FrankBetances/lua-construye/docs/lua-v5-camino-lado.png

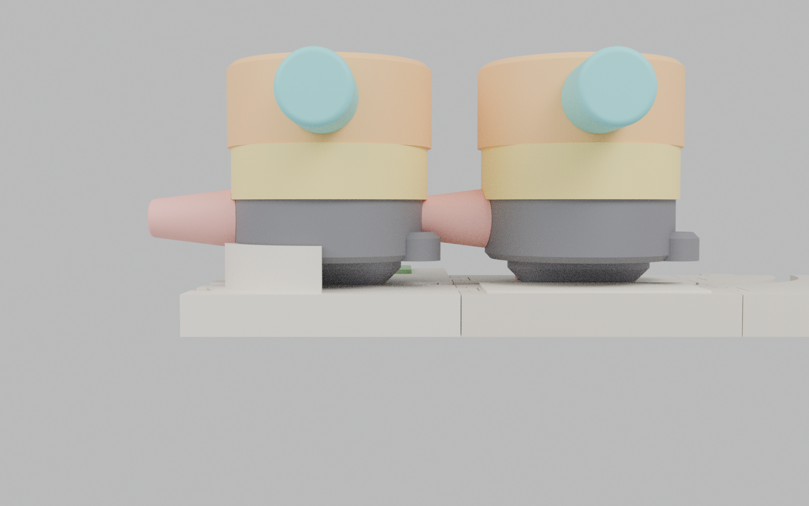
docs/lua-v5-camino-lado.png
