FrankBetances/lua-construye/docs/lua-v5-camino.png

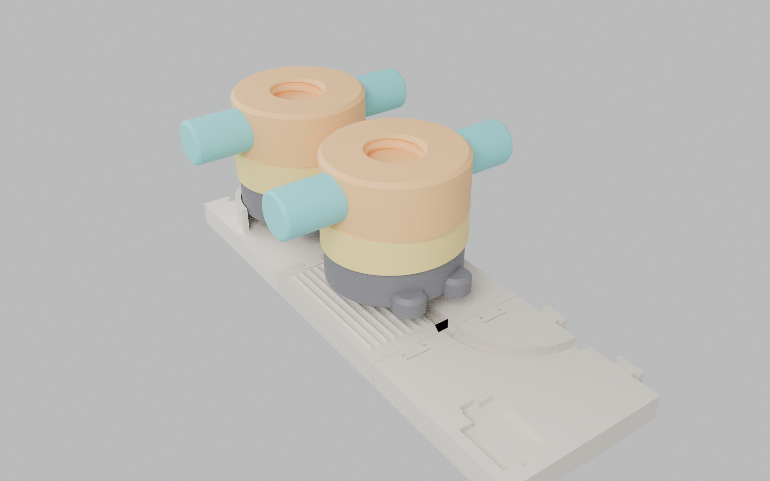
docs/lua-v5-camino.png
