FrankBetances/lua-construye/escenas-juego/escenas/S0-kit-lua.png

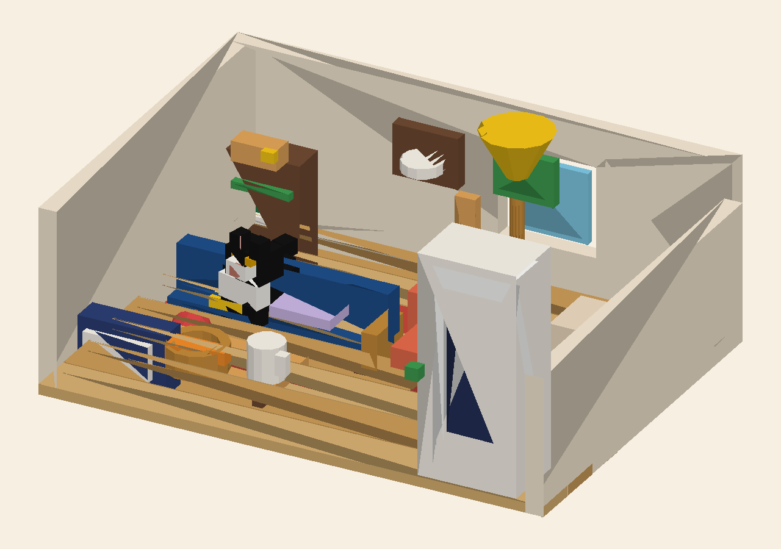
escenas-juego/escenas/S0-kit-lua.png
