FrankBetances/lua-construye/escenas-juego/escenas/S1-camino.png

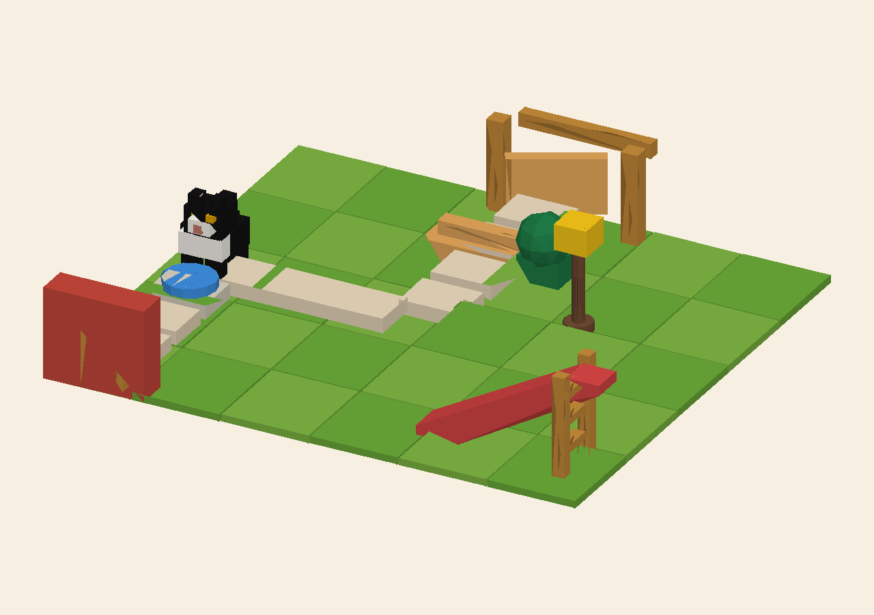
escenas-juego/escenas/S1-camino.png
