FrankBetances/lua-construye/escenas-juego/escenas/S2-estacion-sonido.png

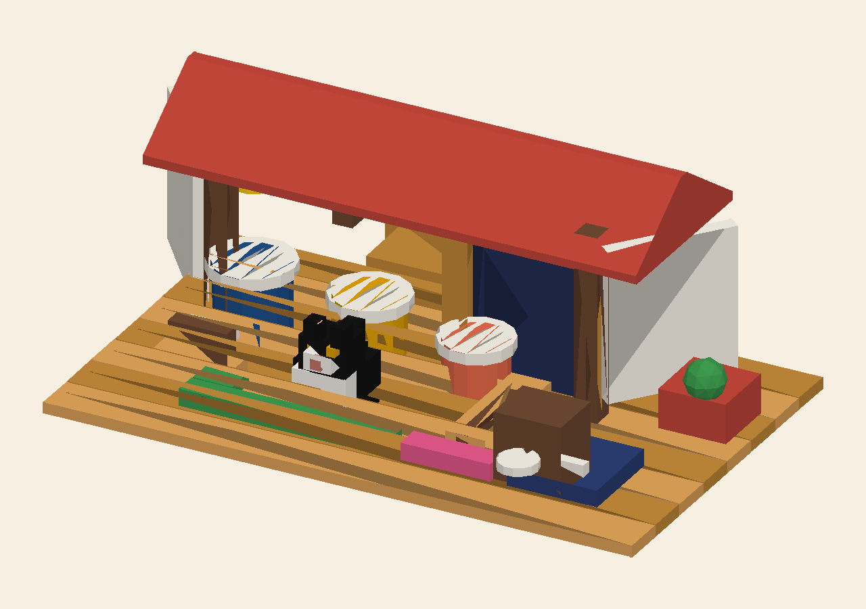
escenas-juego/escenas/S2-estacion-sonido.png
