FrankBetances/lua-construye/escenas-juego/escenas/S3-laboratorio-rampas.png

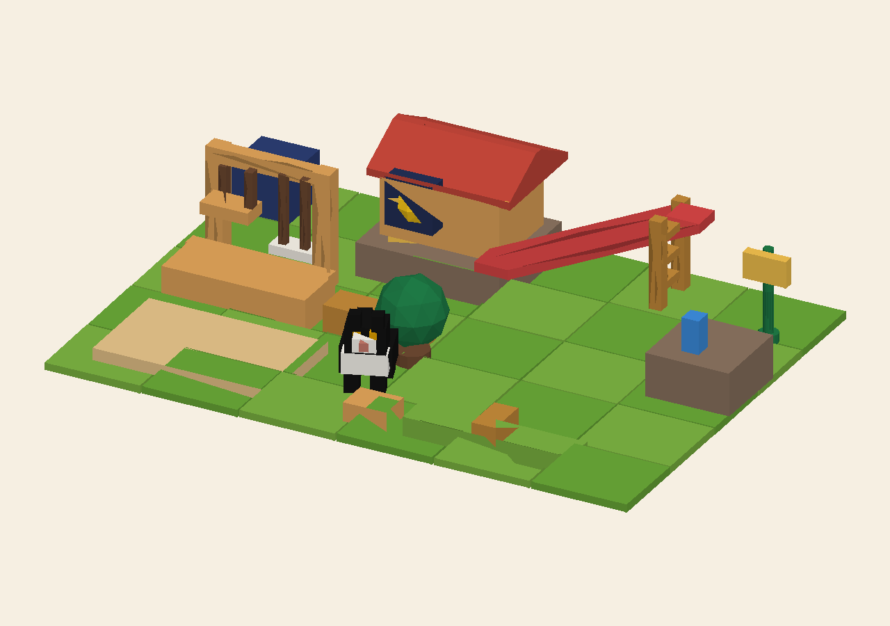
escenas-juego/escenas/S3-laboratorio-rampas.png
