FrankBetances/lua-construye/escenas-juego/escenas/S4-maquina-soplo.png

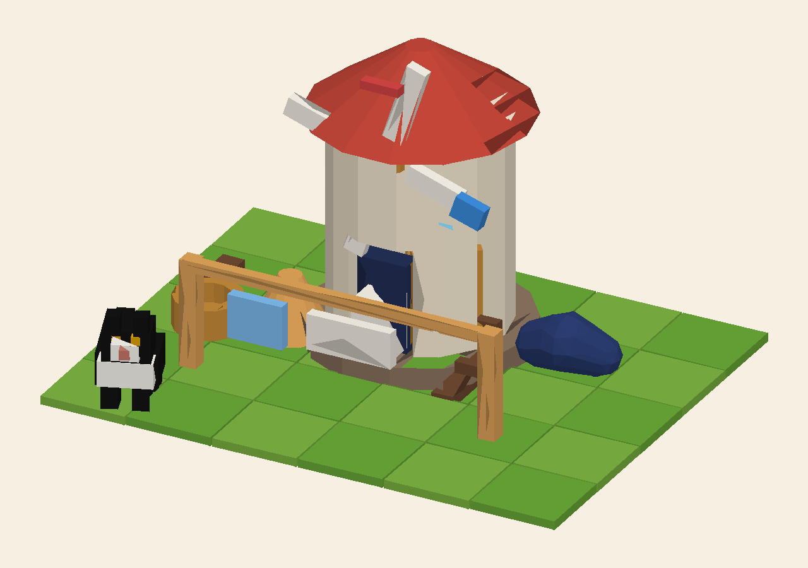
escenas-juego/escenas/S4-maquina-soplo.png
