FrankBetances/lua-construye/escenas-juego/escenas/S5-puente-equilibrio.png

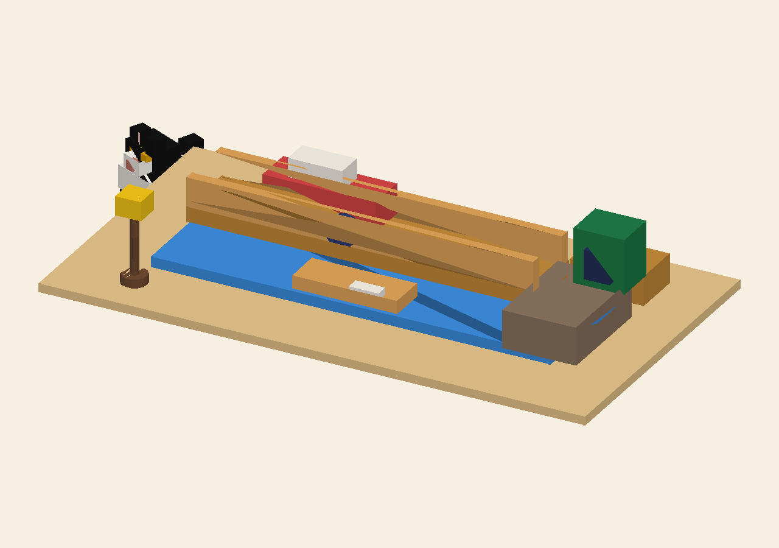
escenas-juego/escenas/S5-puente-equilibrio.png
