FrankBetances/lua-construye/escenas-juego/escenas/S6-jardin.png

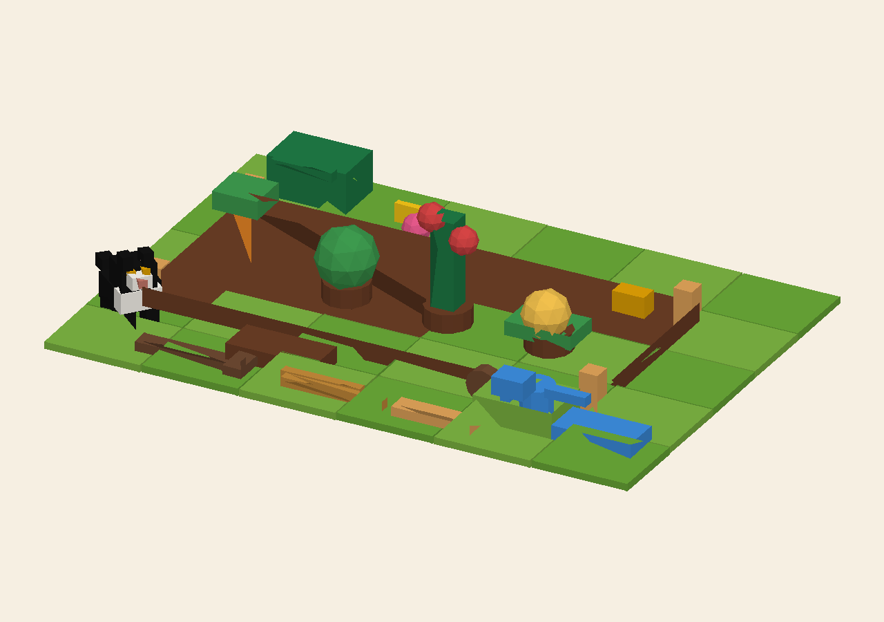
escenas-juego/escenas/S6-jardin.png
