FrankBetances/lua-construye/escenas-juego/escenas/S7-granja.png

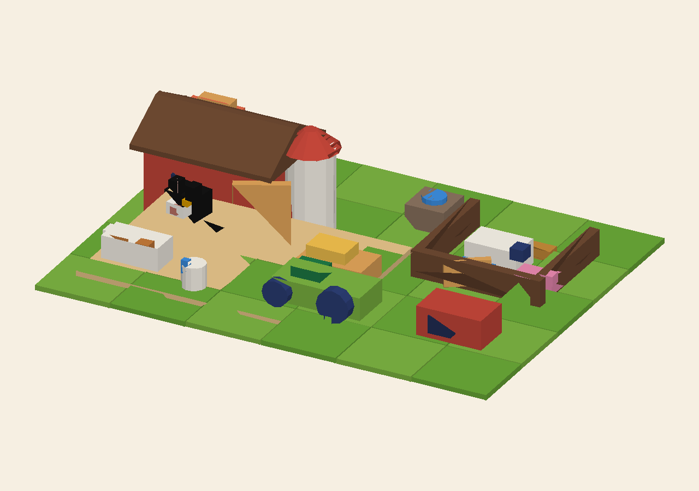
escenas-juego/escenas/S7-granja.png
