FrankBetances/lua-construye/sets/P1-probeta-encaje/tarjetas/despiece.png

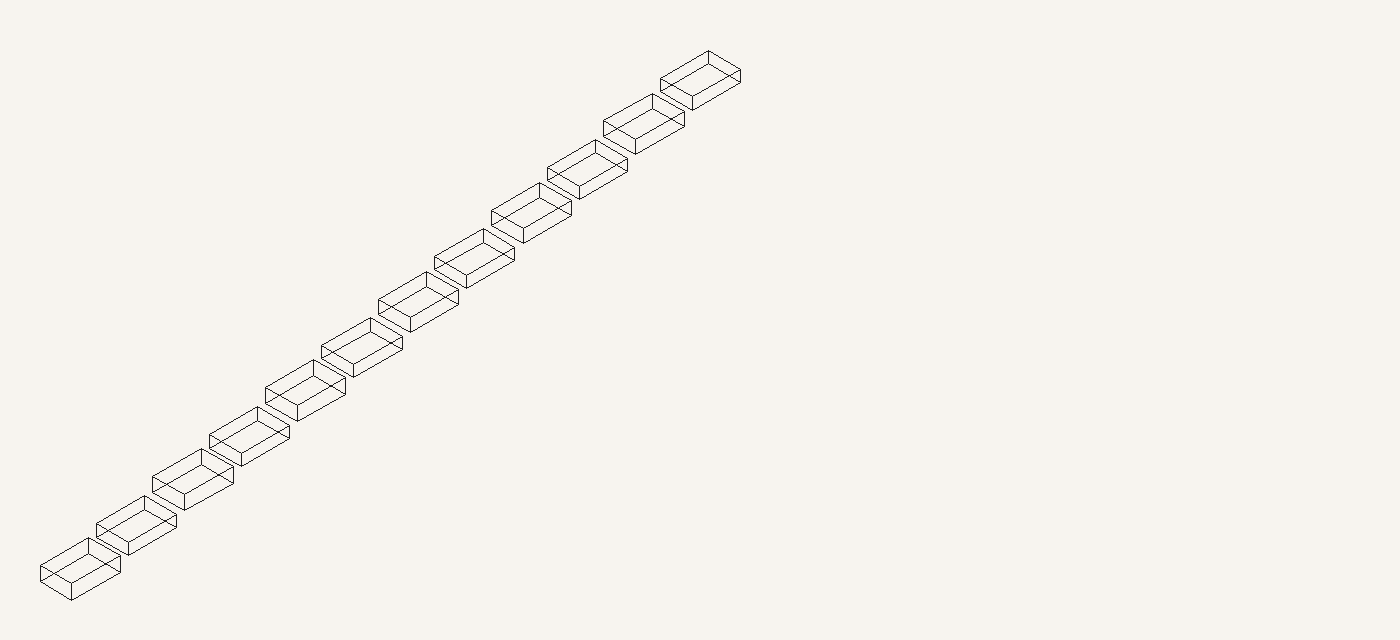
sets/P1-probeta-encaje/tarjetas/despiece.png
