FrankBetances/lua-construye/sets/P1-probeta-encaje/tarjetas/planta.png

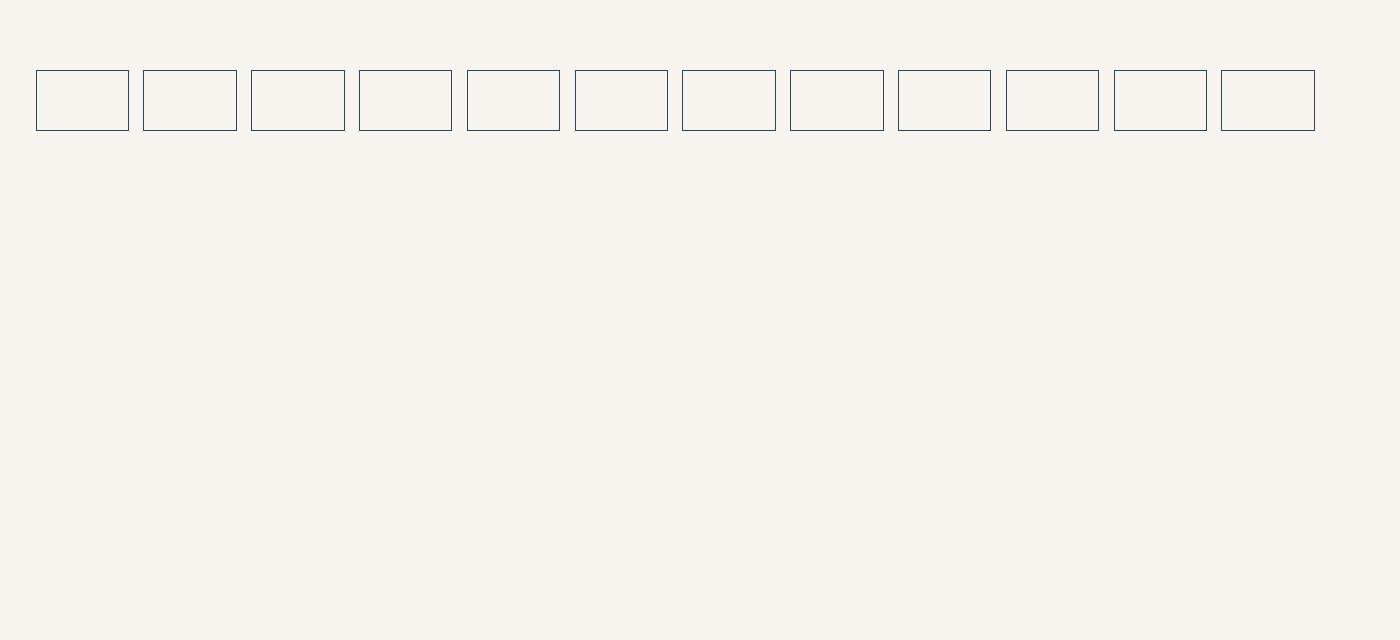
sets/P1-probeta-encaje/tarjetas/planta.png
