FrankBetances/lua-construye/sets/S0-kit-lua/tarjetas/despiece.png

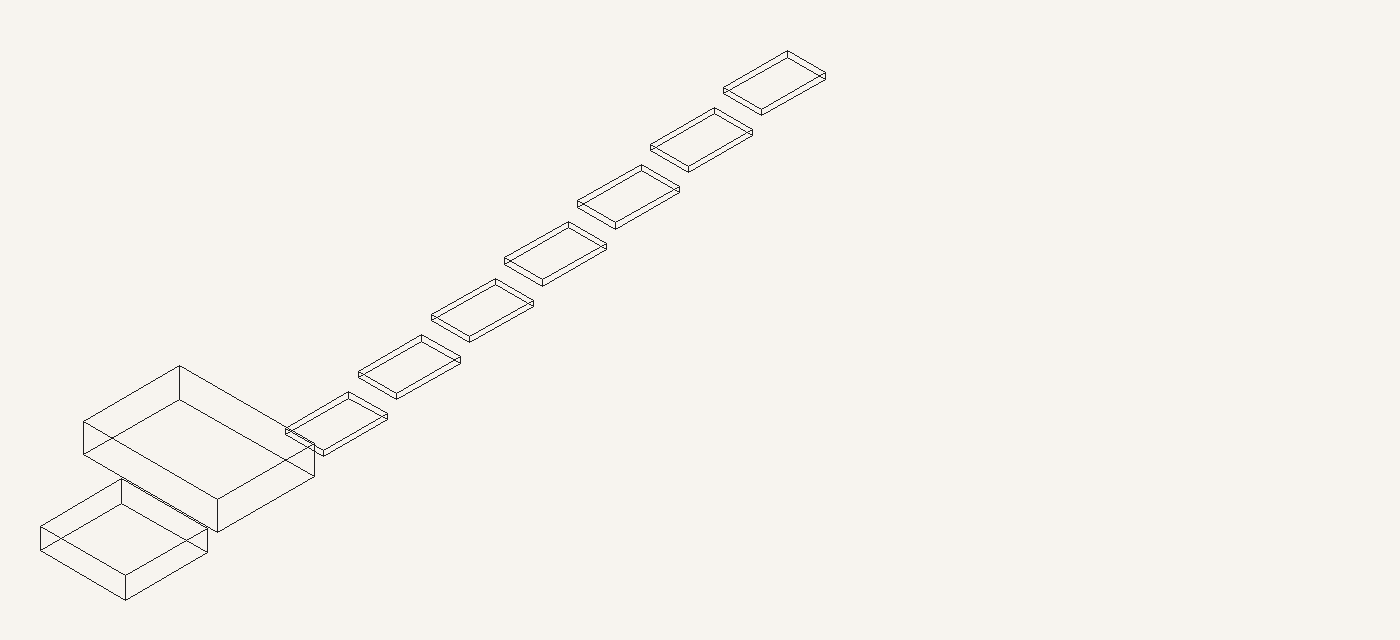
sets/S0-kit-lua/tarjetas/despiece.png
