FrankBetances/lua-construye/sets/S0-kit-lua/tarjetas/planta.png

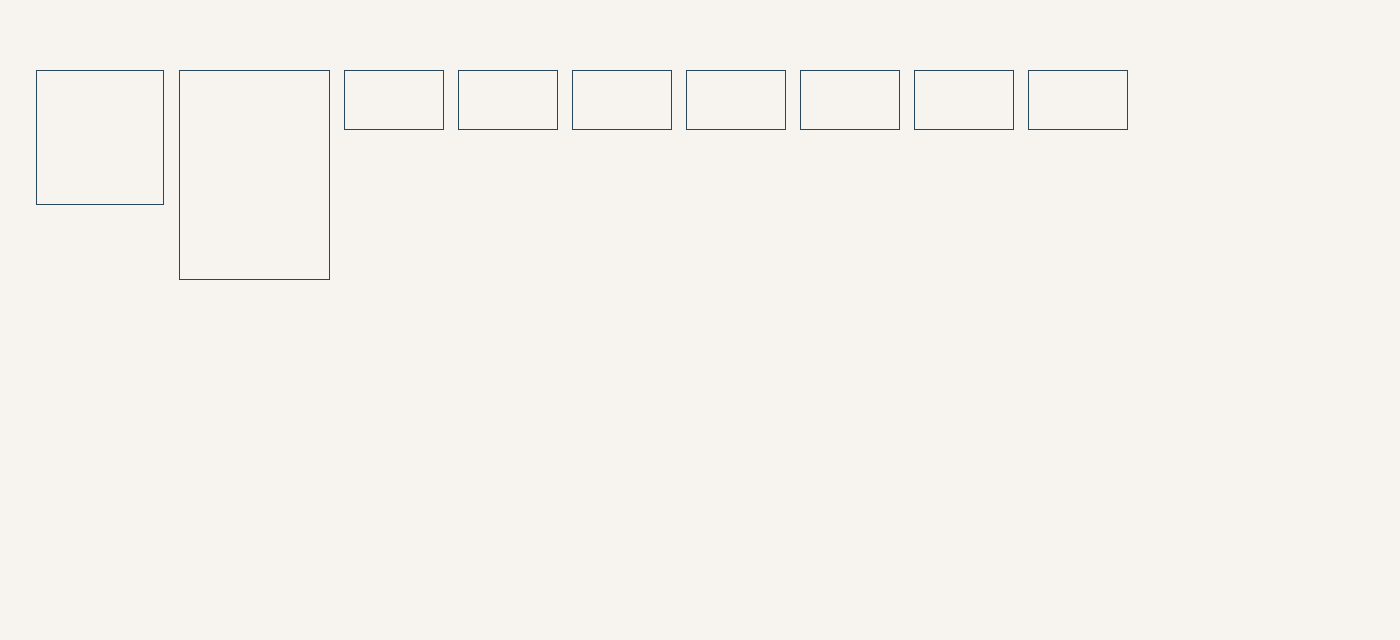
sets/S0-kit-lua/tarjetas/planta.png
