FrankBetances/lua-construye/sets/S1-camino/tarjetas/curva-planta.png

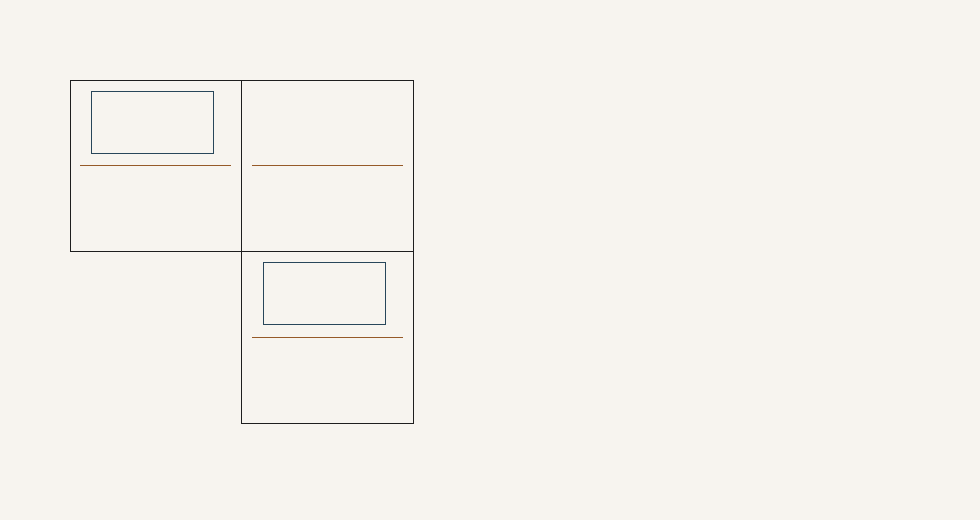
sets/S1-camino/tarjetas/curva-planta.png
