FrankBetances/lua-construye/sets/S1-camino/tarjetas/recta-despiece.png

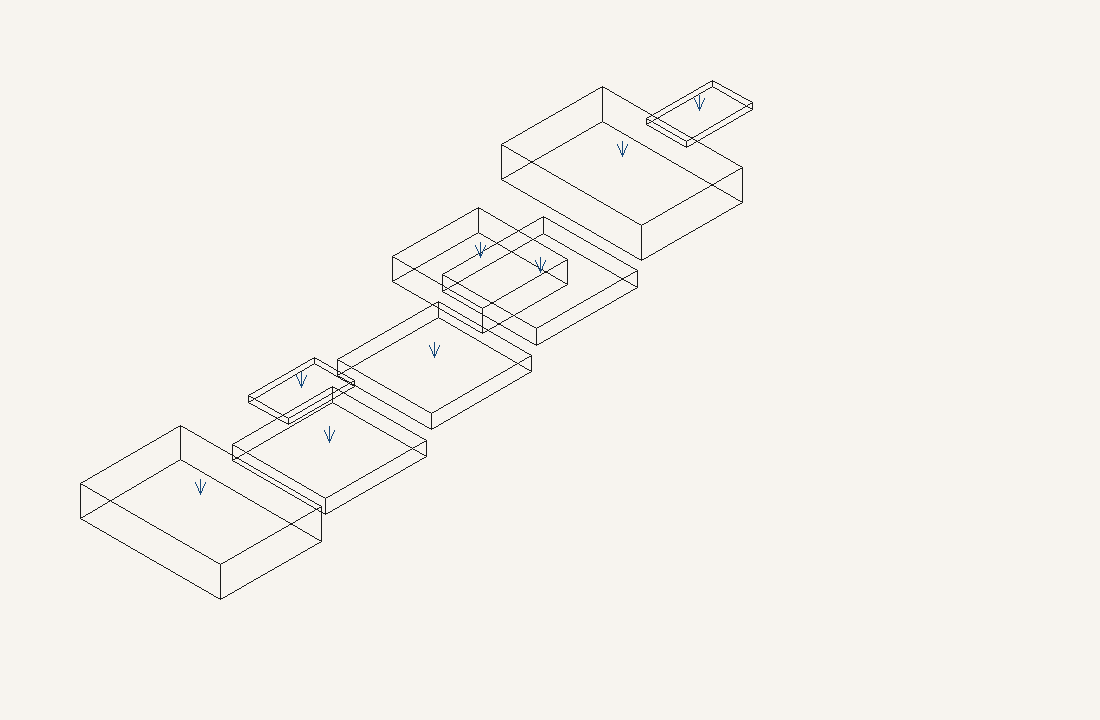
sets/S1-camino/tarjetas/recta-despiece.png
