FrankBetances/lua-construye/sets/S1-camino/tarjetas/recta-planta.png

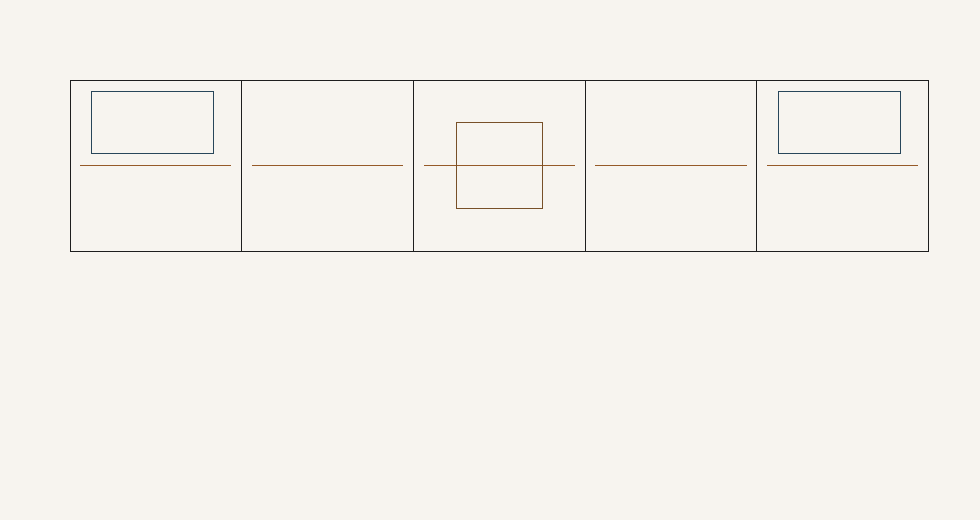
sets/S1-camino/tarjetas/recta-planta.png
