FrankBetances/lua-construye/sets/S1-camino/tarjetas/te-planta.png

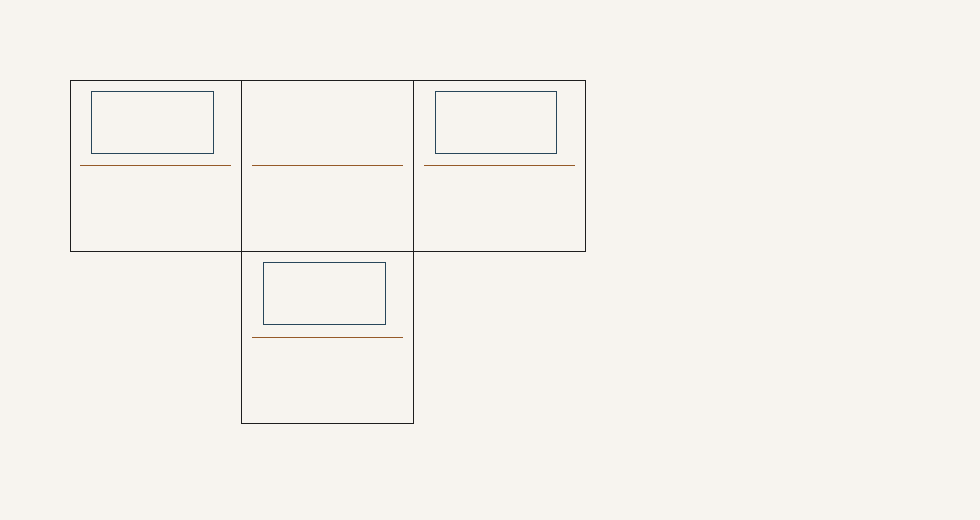
sets/S1-camino/tarjetas/te-planta.png
