FrankBetances/lua-construye/sets/S2-estacion-sonido/tarjetas/despiece.png

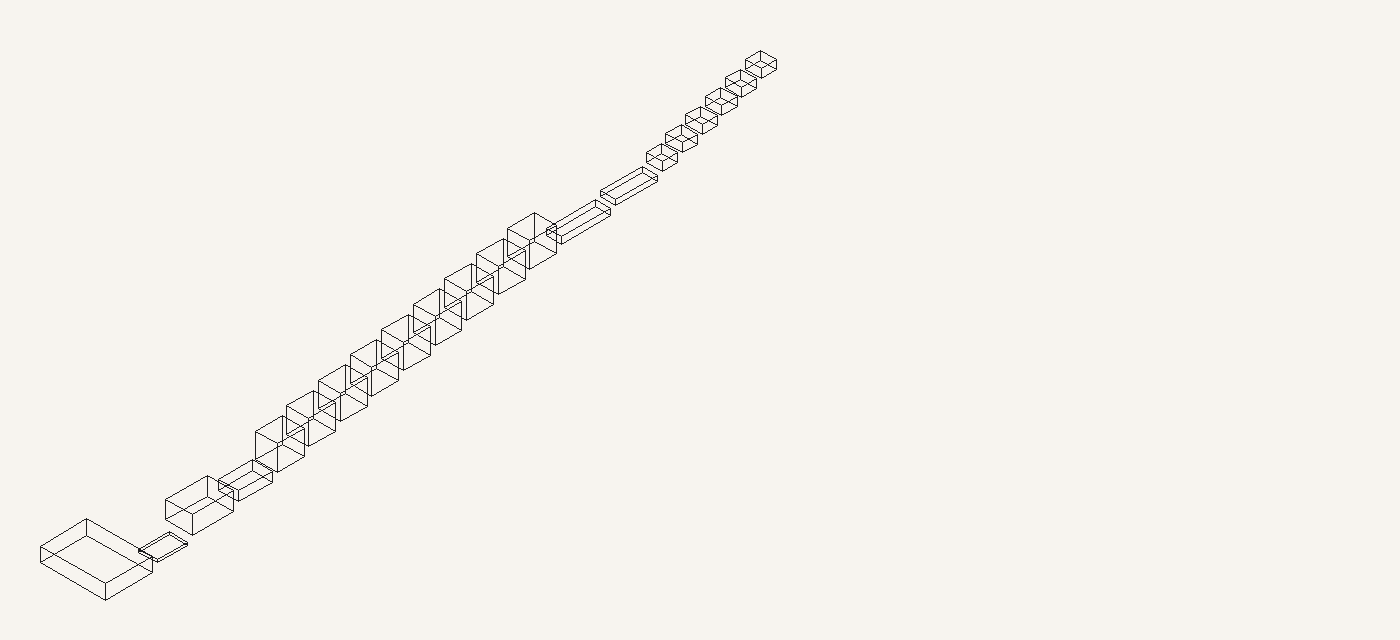
sets/S2-estacion-sonido/tarjetas/despiece.png
