FrankBetances/lua-construye/sets/S3-laboratorio-rampas/tarjetas/planta.png

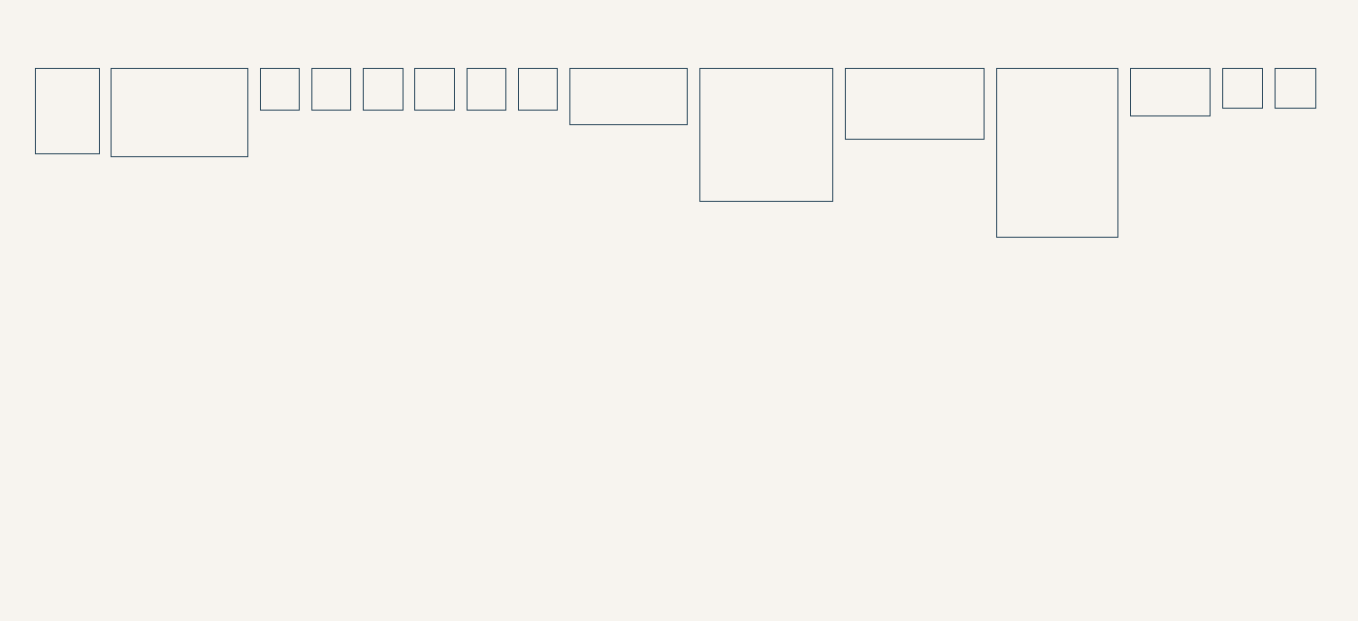
sets/S3-laboratorio-rampas/tarjetas/planta.png
