FrankBetances/lua-construye/sets/S4-maquina-soplo/tarjetas/planta.png

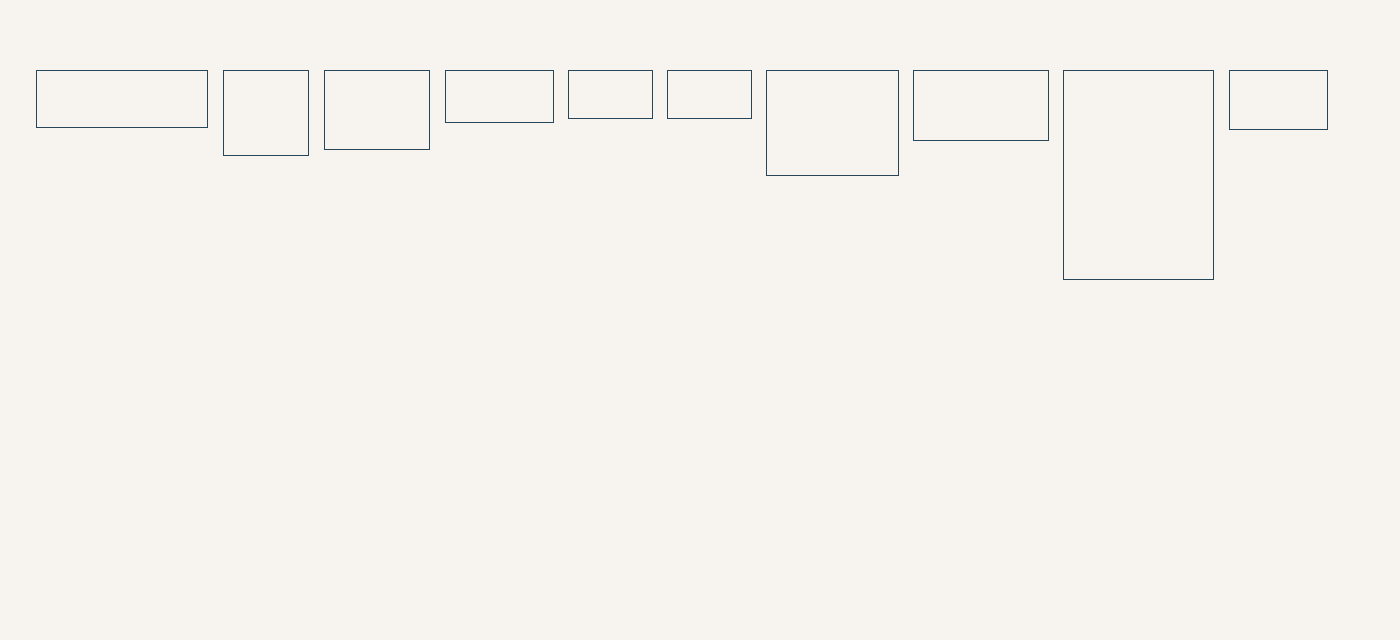
sets/S4-maquina-soplo/tarjetas/planta.png
