FrankBetances/lua-construye/sets/S5-puente-equilibrio/tarjetas/planta.png

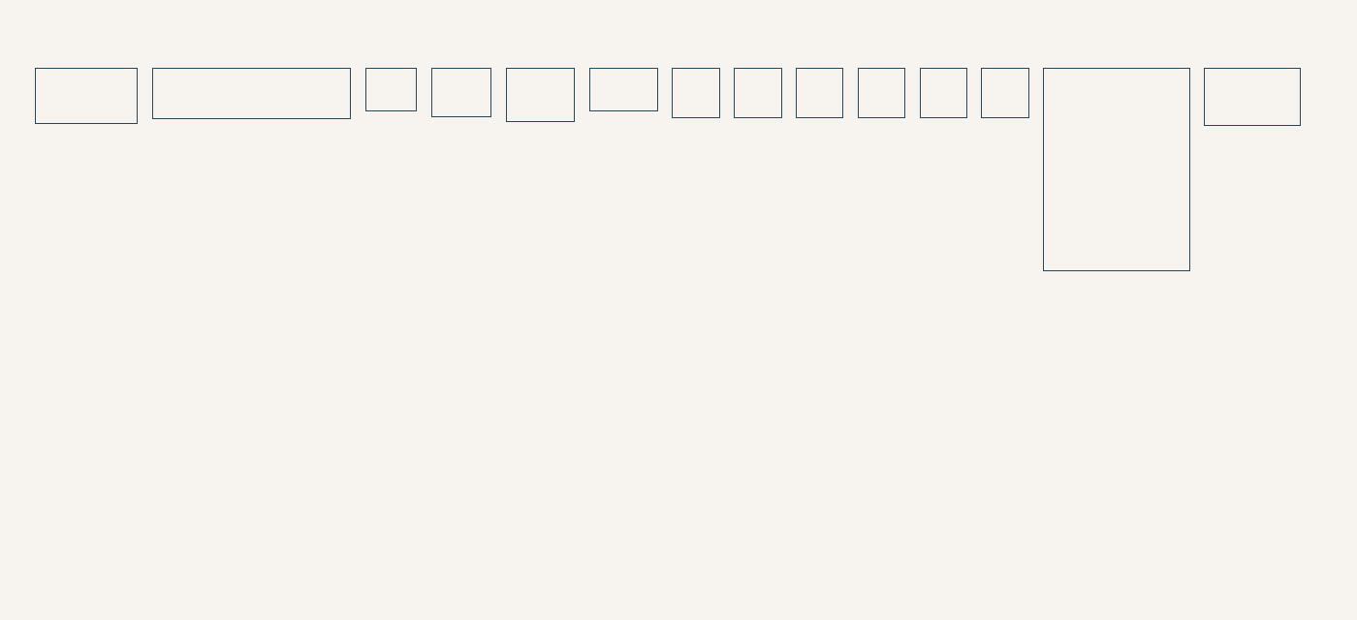
sets/S5-puente-equilibrio/tarjetas/planta.png
