FrankBetances/lua-construye/sets/S6-jardin/tarjetas/planta.png

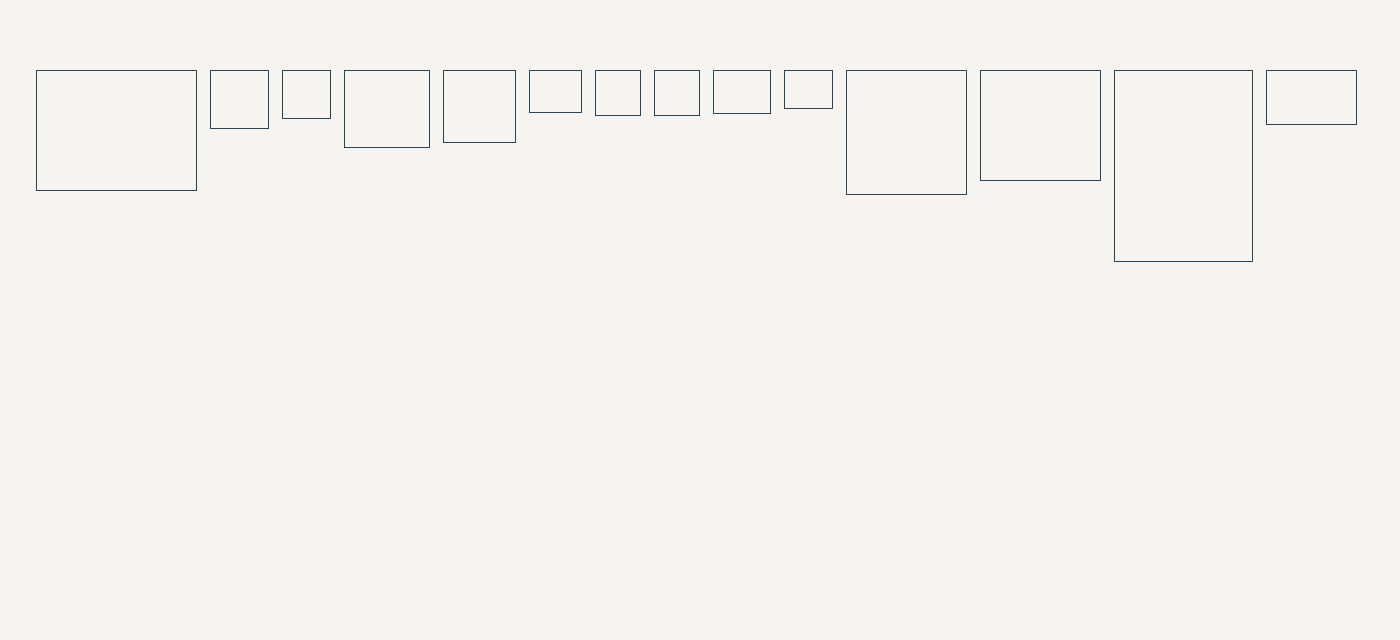
sets/S6-jardin/tarjetas/planta.png
