FrankBetances/lua-construye/sets/S8-policia/escena.png

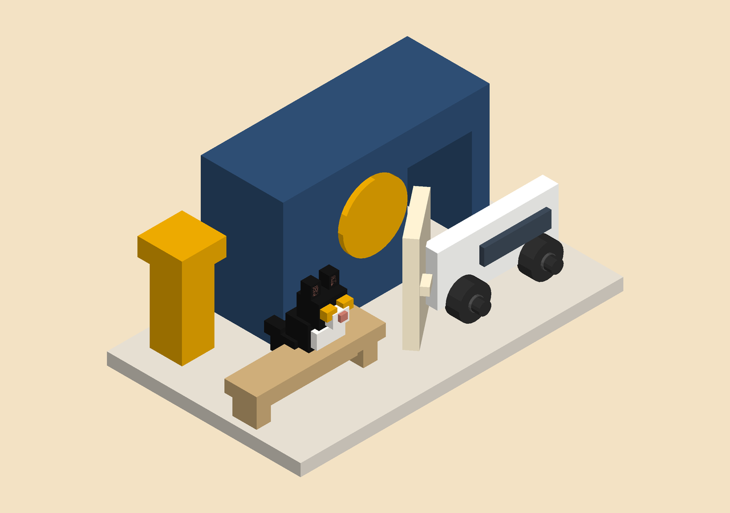
sets/S8-policia/escena.png
