FrankBetances/lua-construye/sets/S9-bomberos/escena.png

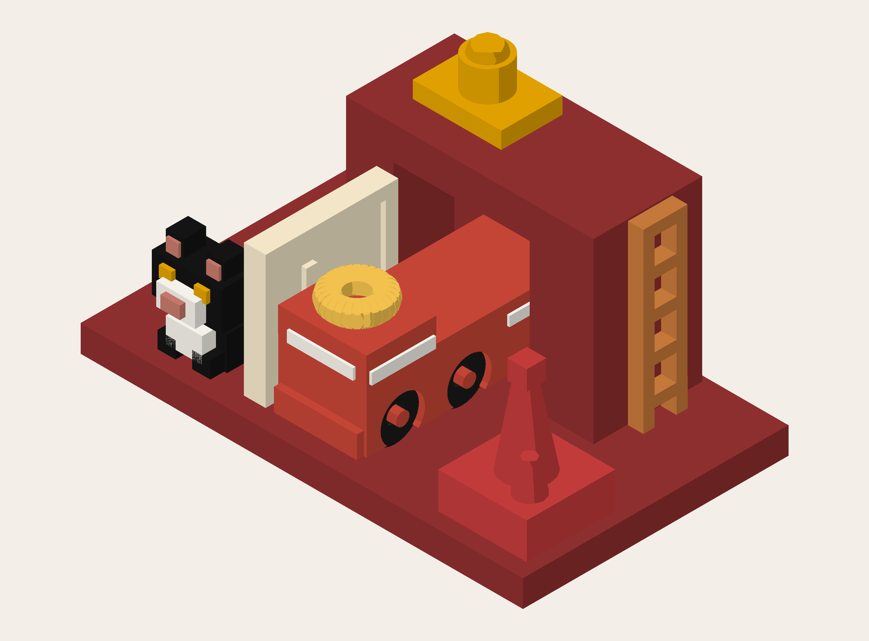
sets/S9-bomberos/escena.png
