FrankBetances/lua-construye/sets/S10-hospital/escena.png

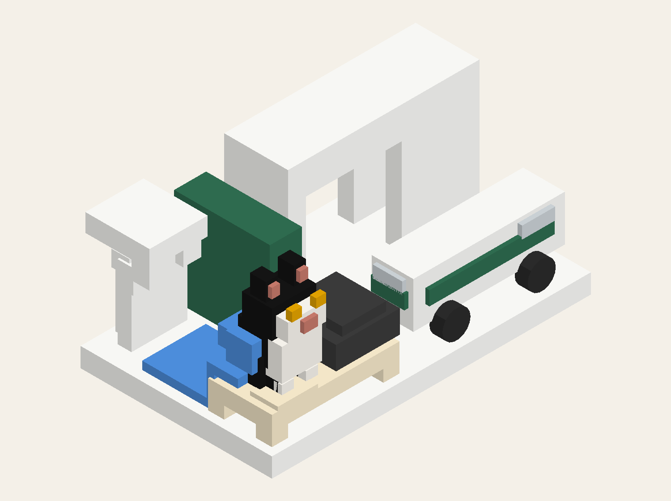
sets/S10-hospital/escena.png
