FrankBetances/lua-construye/sets/S11-trenes/escena.png

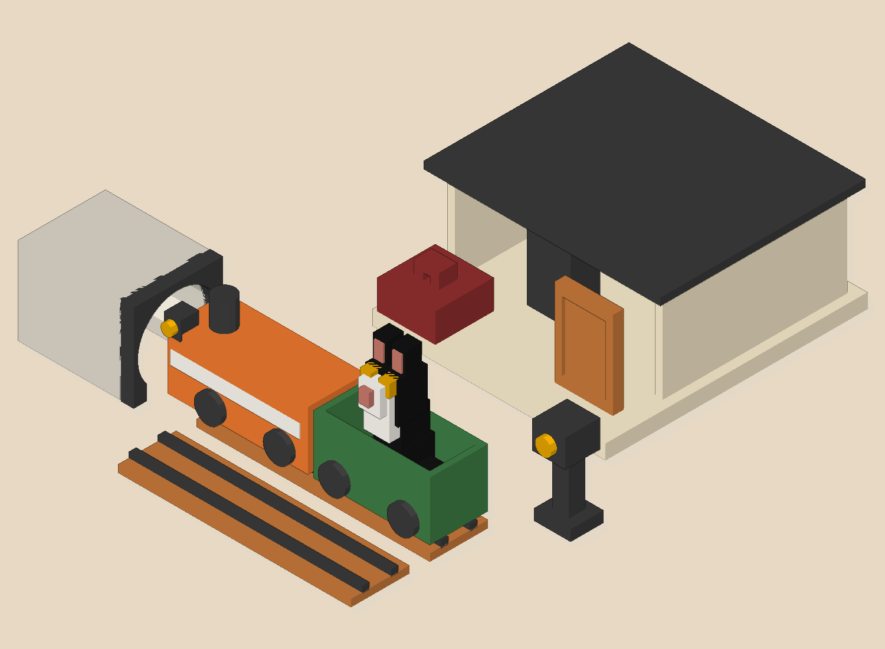
sets/S11-trenes/escena.png
