FrankBetances/lua-construye/entrega/masque3d-sets-v1/S1-camino/S1-REC-LIS-G.stl

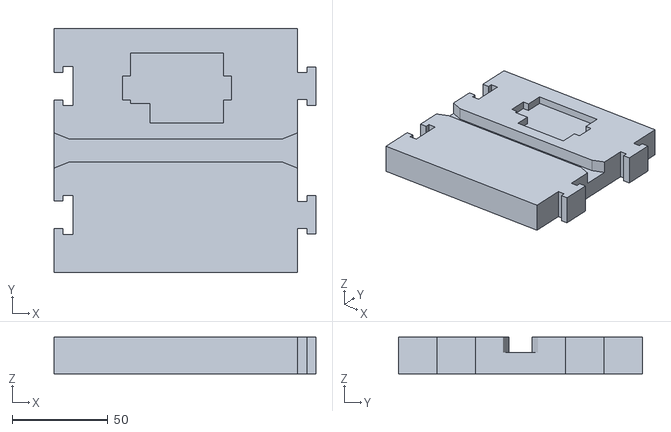
[picture p30: CAD file, 2026-10-30]
entrega/masque3d-sets-v1/S1-camino/S1-REC-LIS-G.stl
136.8 x 127.2 x 19.2
