FrankBetances/lua-construye/entrega/masque3d-sets-v1/S10-hospital/S10-hospital-escala-60.stl

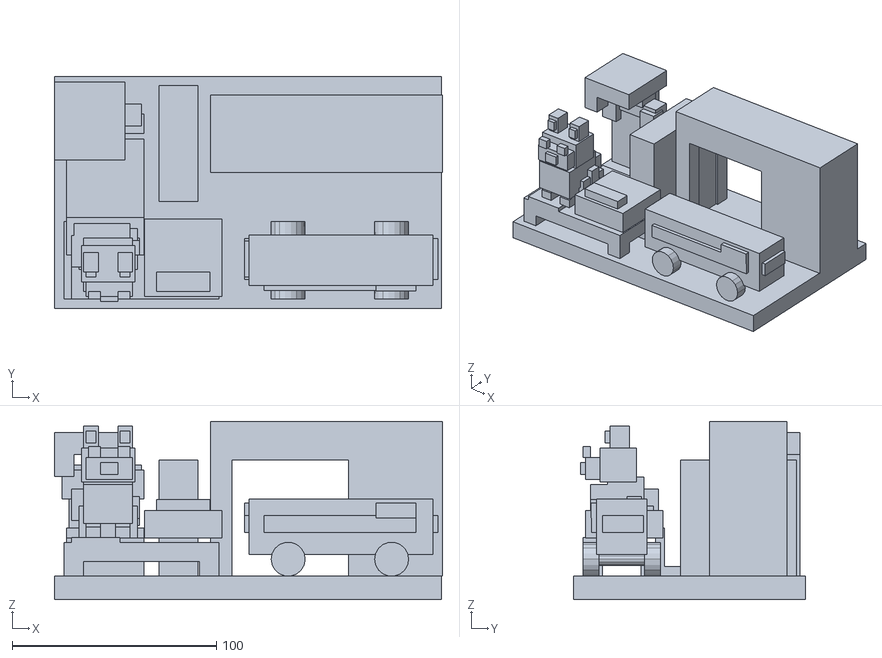
[picture p31: CAD file, 2026-10-30]
entrega/masque3d-sets-v1/S10-hospital/S10-hospital-escala-60.stl
190.0 x 113.7 x 87.3
