FrankBetances/lua-construye/entrega/masque3d-sets-v1/S11-trenes/S11-trenes-escala-33.stl

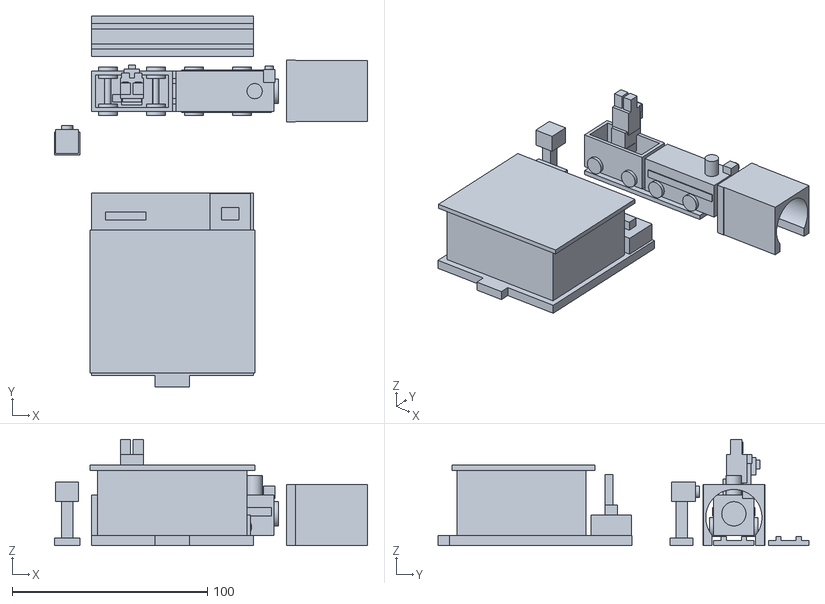
[picture p32: CAD file, 2026-10-30]
entrega/masque3d-sets-v1/S11-trenes/S11-trenes-escala-33.stl
160.5 x 190.0 x 54.4
