FrankBetances/lua-construye/entrega/masque3d-sets-v1/S2-estacion-sonido/S2-ESP-E.stl

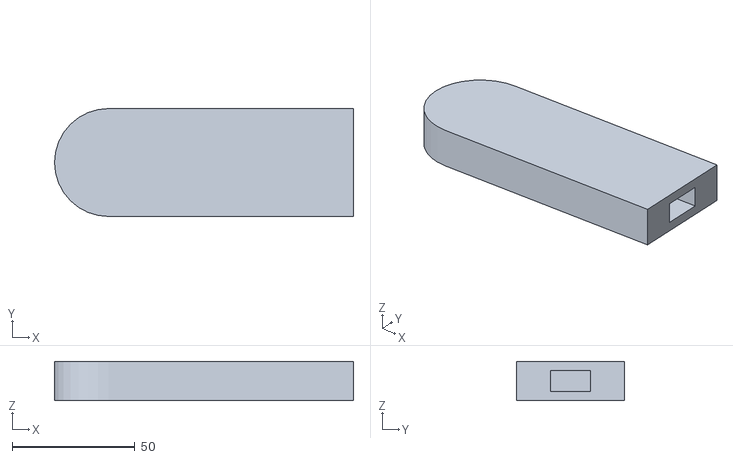
[picture p33: CAD file, 2026-10-30]
entrega/masque3d-sets-v1/S2-estacion-sonido/S2-ESP-E.stl
122.0 x 44.0 x 16.0
