FrankBetances/lua-construye/entrega/masque3d-sets-v1/S3-laboratorio-rampas/S3-CUR-PER-G.stl

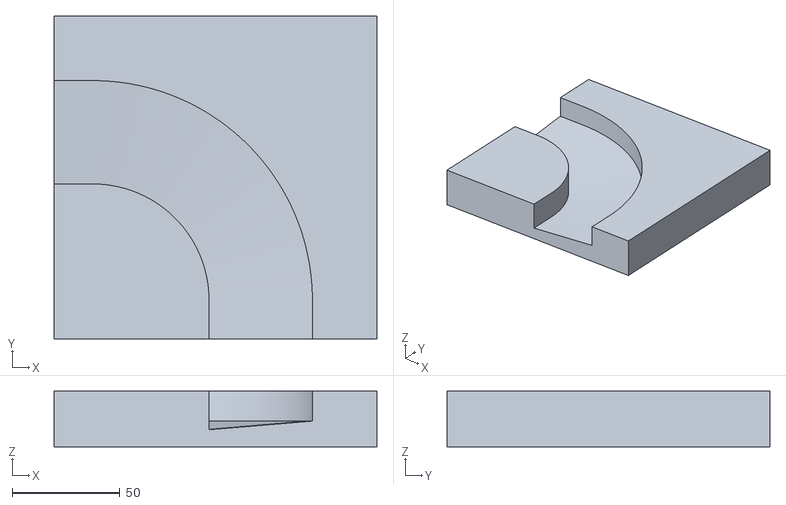
[picture p34: CAD file, 2026-10-30]
entrega/masque3d-sets-v1/S3-laboratorio-rampas/S3-CUR-PER-G.stl
150.0 x 150.0 x 26.0
