FrankBetances/lua-construye/entrega/masque3d-sets-v1/S4-maquina-soplo/S4-CAN-E.stl

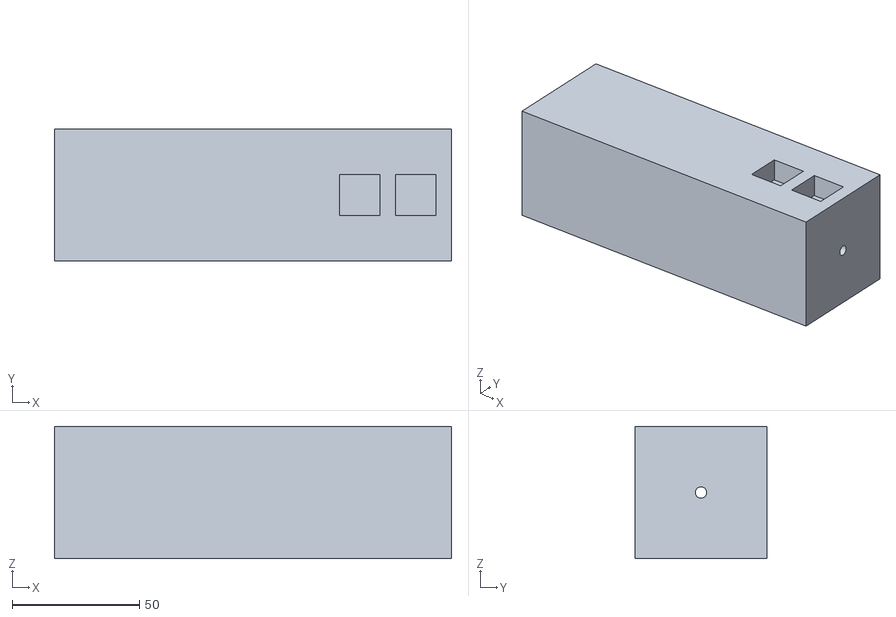
[picture p35: CAD file, 2026-10-30]
entrega/masque3d-sets-v1/S4-maquina-soplo/S4-CAN-E.stl
156.0 x 52.0 x 52.0
