FrankBetances/lua-construye/entrega/masque3d-sets-v1/S5-puente-equilibrio/S5-FUL-G.stl

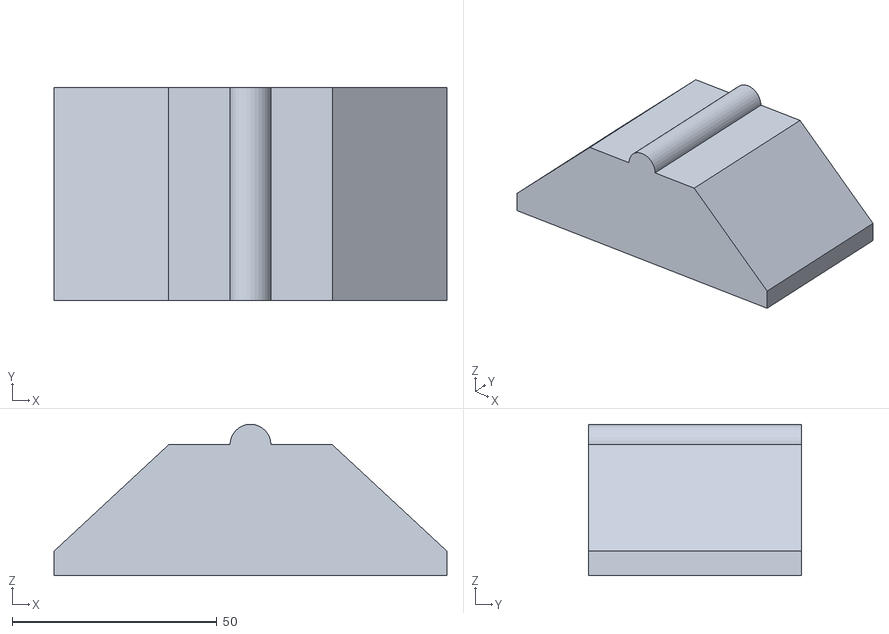
[picture p36: CAD file, 2026-10-30]
entrega/masque3d-sets-v1/S5-puente-equilibrio/S5-FUL-G.stl
96.0 x 52.0 x 37.0
