FrankBetances/lua-construye/entrega/masque3d-sets-v1/S6-jardin/S6-SEM-G.stl

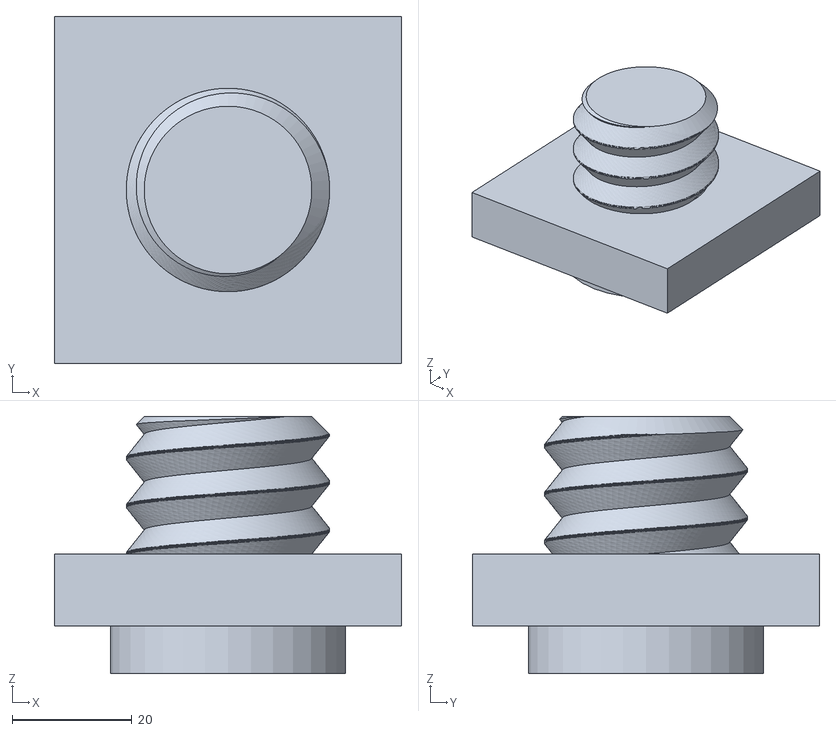
[picture p37: CAD file, 2026-10-30]
entrega/masque3d-sets-v1/S6-jardin/S6-SEM-G.stl
58.0 x 58.0 x 43.0
