FrankBetances/lua-construye/entrega/masque3d-sets-v1/S8-policia/S8-policia-escala-60.stl

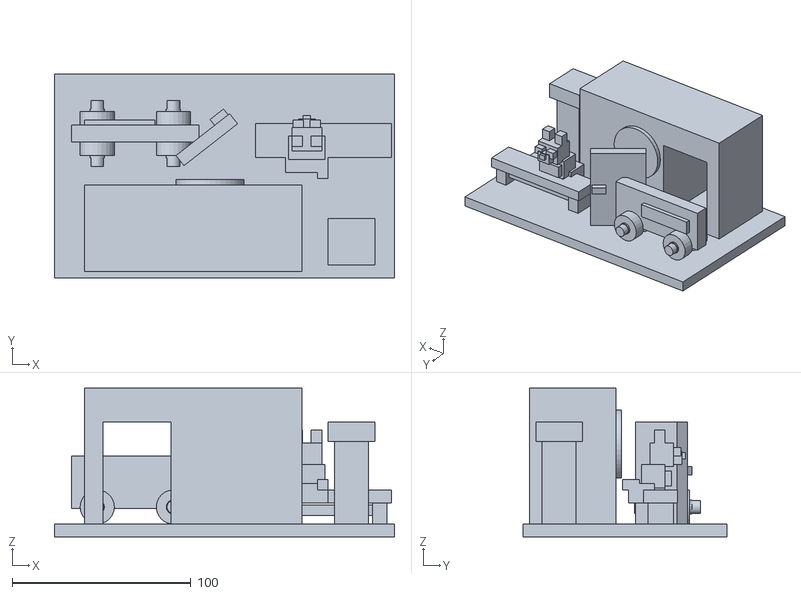
[picture p38: CAD file, 2026-10-30]
entrega/masque3d-sets-v1/S8-policia/S8-policia-escala-60.stl
190.0 x 114.0 x 83.2
