FrankBetances/lua-construye/entrega/masque3d-sets-v1/S9-bomberos/S9-bomberos-escala-60.stl

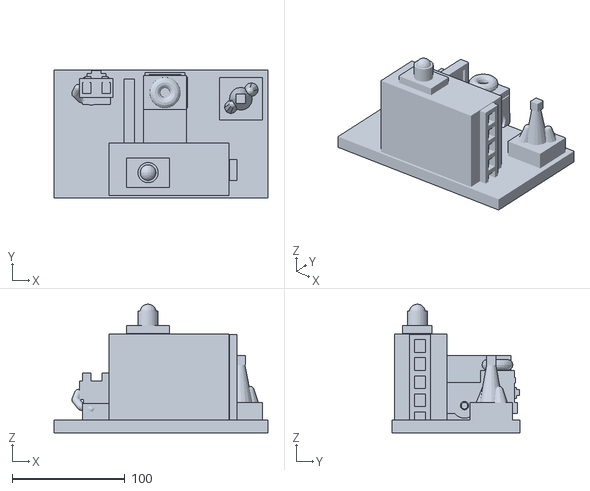
[picture p39: CAD file, 2026-10-30]
entrega/masque3d-sets-v1/S9-bomberos/S9-bomberos-escala-60.stl
190.0 x 114.0 x 114.4
