FrankBetances/lua-construye/escenas-juego/escenas/S2-estacion-sonido.stl

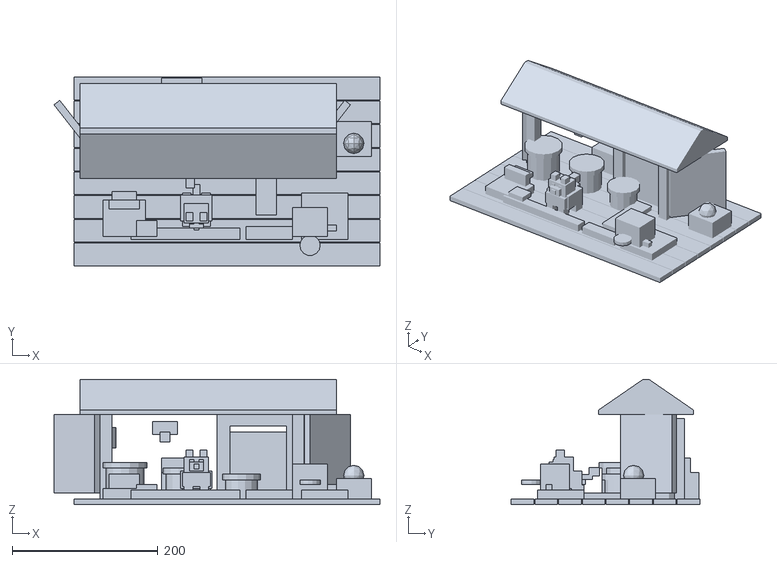
[picture p40: CAD file, 2026-10-29]
escenas-juego/escenas/S2-estacion-sonido.stl
447.4 x 258.8 x 172.0
