FrankBetances/lua-construye/sets/S0-kit-lua/stl/K-ZOCALO-G.stl

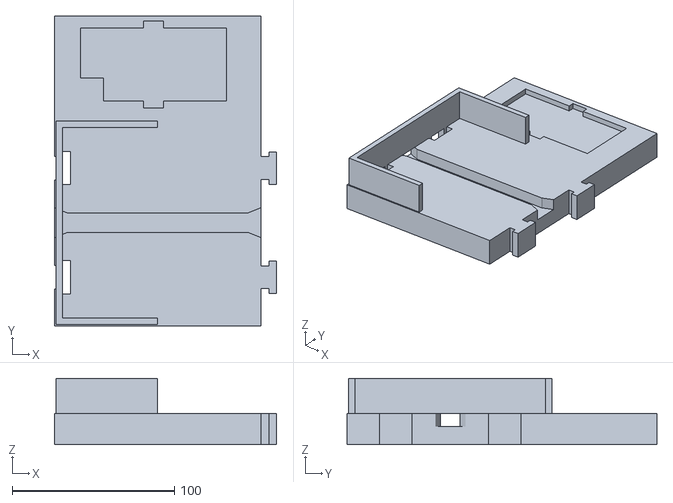
[picture p41: CAD file, 2026-10-30]
sets/S0-kit-lua/stl/K-ZOCALO-G.stl
136.8 x 190.8 x 40.8
