FrankBetances/lua-construye/sets/S10-hospital/stl/conjunto.stl

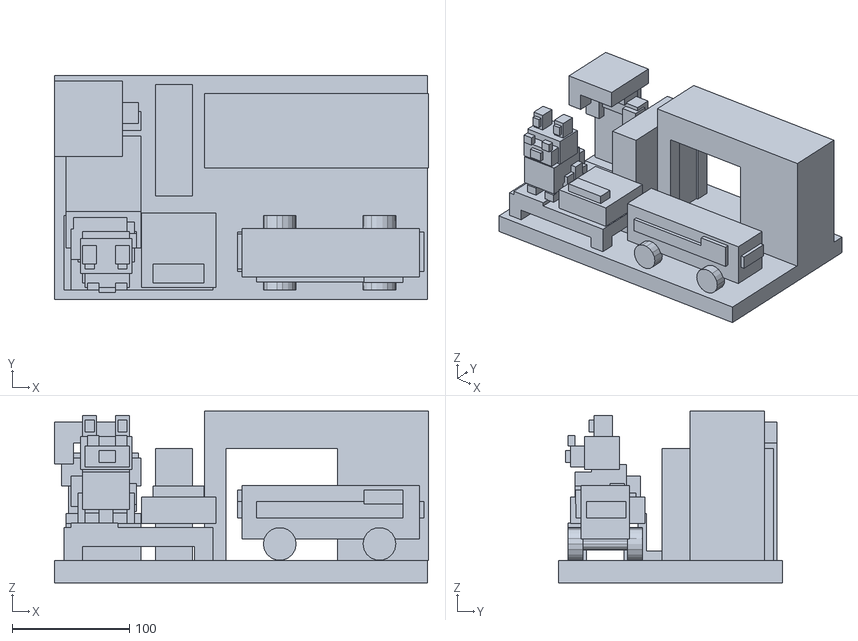
[picture p42: CAD file, 2026-10-29]
sets/S10-hospital/stl/conjunto.stl
318.8 x 190.8 x 146.4
