FrankBetances/lua-construye/sets/S11-trenes/stl/conjunto.stl

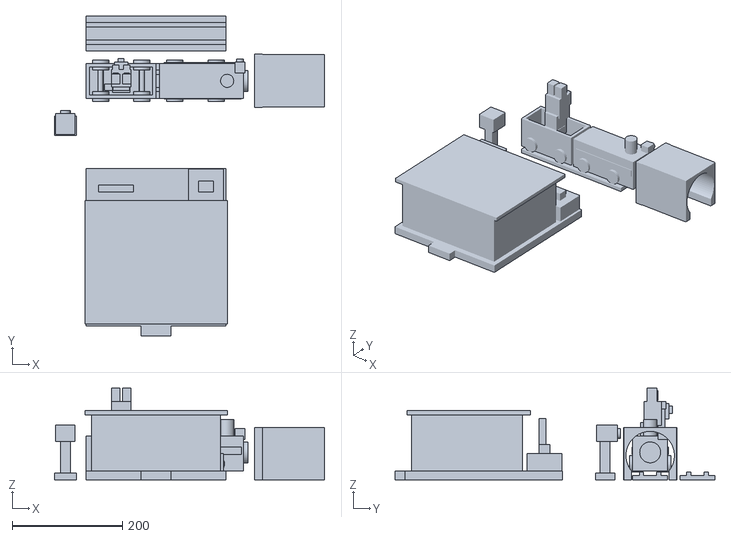
[picture p43: CAD file, 2026-10-29]
sets/S11-trenes/stl/conjunto.stl
491.4 x 581.6 x 166.4
