FrankBetances/lua-construye/sets/S8-policia/stl/conjunto.stl

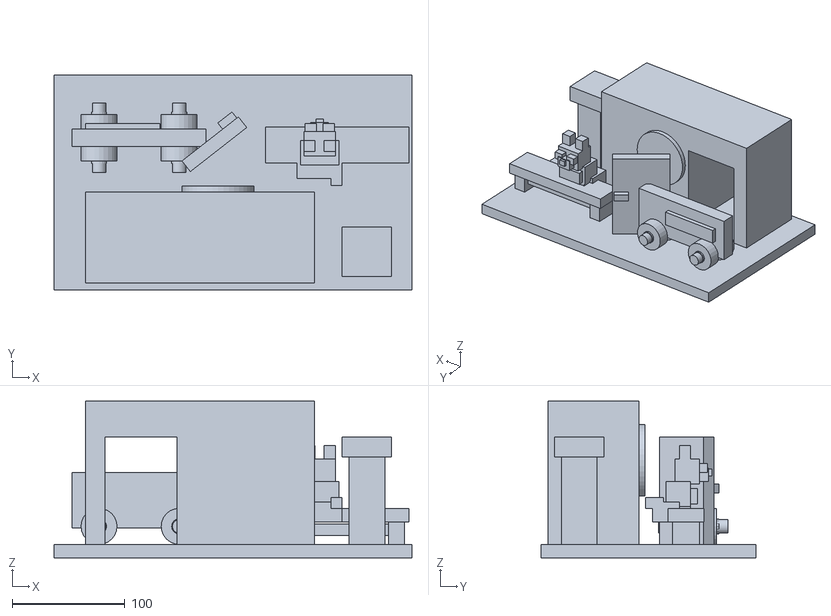
[picture p44: CAD file, 2026-10-29]
sets/S8-policia/stl/conjunto.stl
318.0 x 190.8 x 139.2
