FrankBetances/lua-construye/sets/S9-bomberos/stl/conjunto.stl

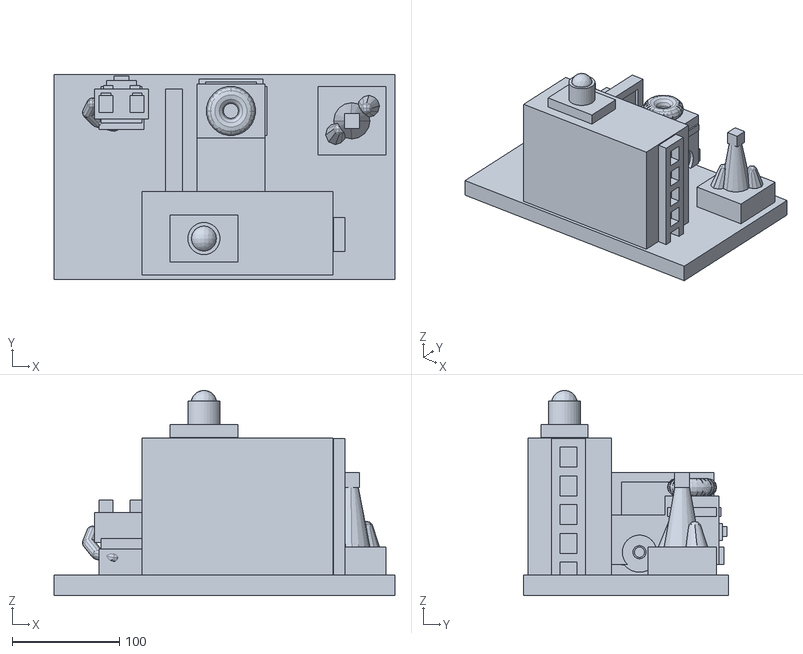
[picture p45: CAD file, 2026-10-29]
sets/S9-bomberos/stl/conjunto.stl
318.0 x 190.8 x 191.4
