FrankBetances/lua-construye/entrega/masque3d-sets-v1/00-comun/K-PATIN-G.stl

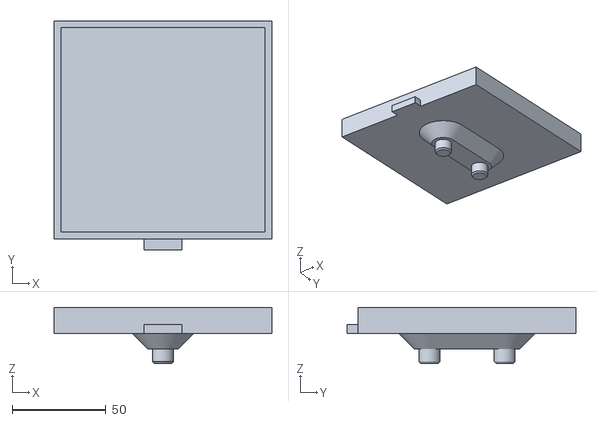
[picture p46: CAD file, 2026-10-30]
entrega/masque3d-sets-v1/00-comun/K-PATIN-G.stl
116.0 x 122.0 x 29.8
