FrankBetances/lua-construye/entrega/masque3d-sets-v1/S1-camino/S1-CMD-GIR-G.stl

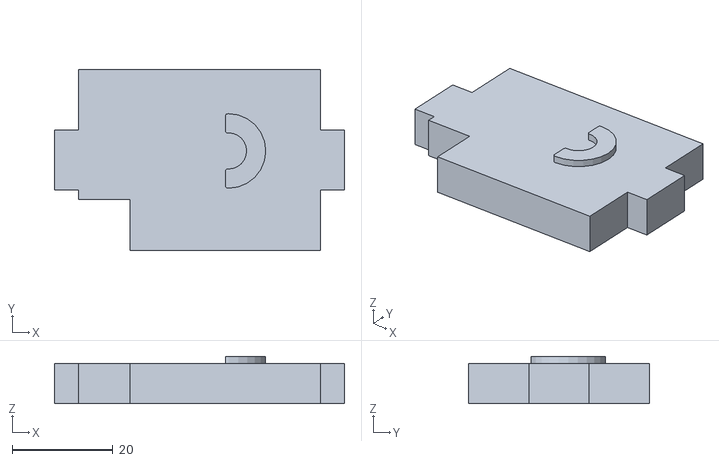
[picture p48: CAD file, 2026-10-30]
entrega/masque3d-sets-v1/S1-camino/S1-CMD-GIR-G.stl
57.6 x 36.0 x 9.40
