FrankBetances/lua-construye/entrega/masque3d-sets-v1/S3-laboratorio-rampas/S3-REC-G.stl

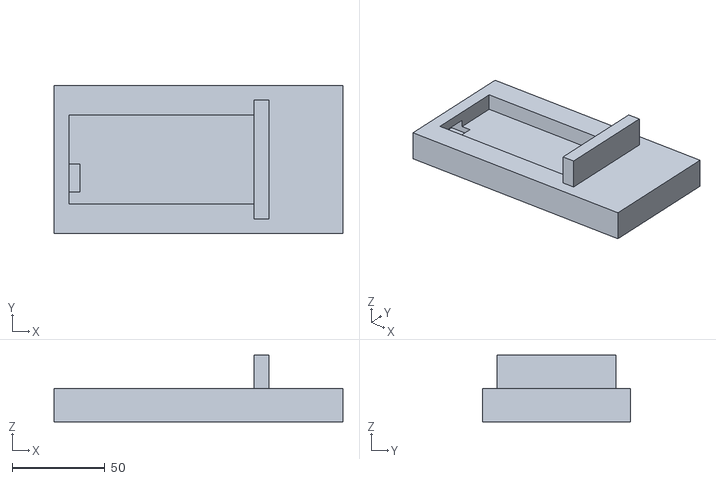
[picture p50: CAD file, 2026-10-30]
entrega/masque3d-sets-v1/S3-laboratorio-rampas/S3-REC-G.stl
156.0 x 80.0 x 36.0
