FrankBetances/lua-construye/entrega/masque3d-sets-v1/S4-maquina-soplo/S4-ROT-ASPAS-E.stl

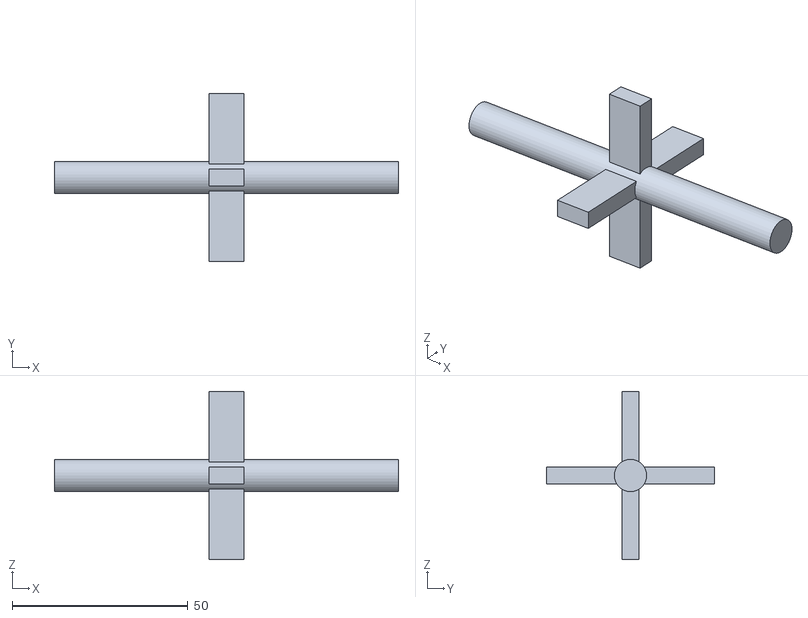
[picture p51: CAD file, 2026-10-30]
entrega/masque3d-sets-v1/S4-maquina-soplo/S4-ROT-ASPAS-E.stl
98.0 x 48.0 x 48.0
