FrankBetances/lua-construye/entrega/masque3d-sets-v1/S5-puente-equilibrio/S5-VIG-G.stl

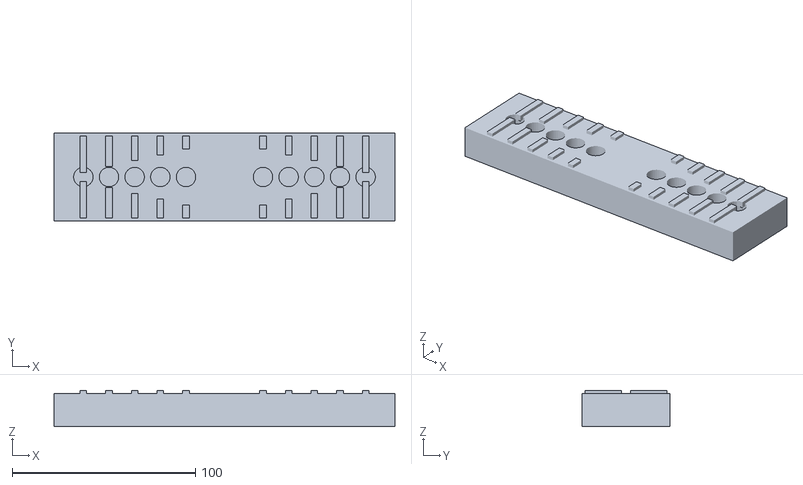
[picture p52: CAD file, 2026-10-30]
entrega/masque3d-sets-v1/S5-puente-equilibrio/S5-VIG-G.stl
186.0 x 48.0 x 19.8
