FrankBetances/lua-construye/entrega/masque3d-sets-v1/S6-jardin/S6-SIL-LUN.stl

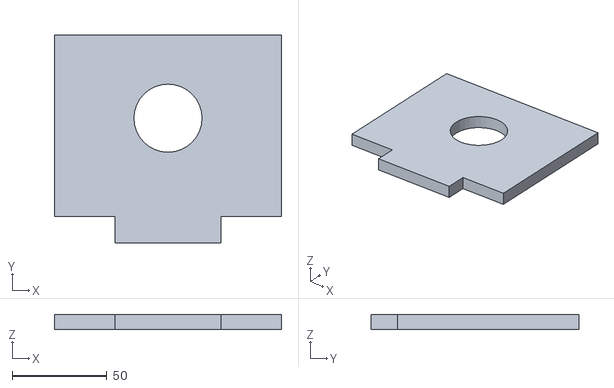
[picture p53: CAD file, 2026-10-30]
entrega/masque3d-sets-v1/S6-jardin/S6-SIL-LUN.stl
120.0 x 110.0 x 8.00
