FrankBetances/lua-construye/escenas-juego/escenas/S6-jardin.stl

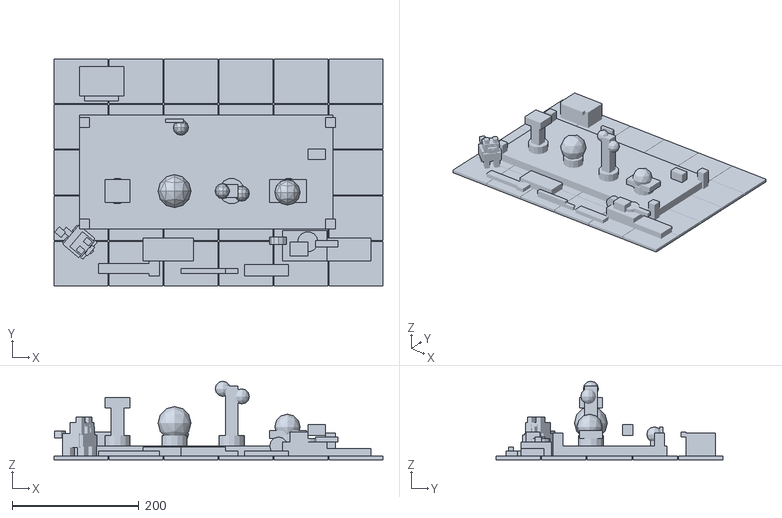
[picture p54: CAD file, 2026-10-29]
escenas-juego/escenas/S6-jardin.stl
518.6 x 358.6 x 124.0
