FrankBetances/lua-construye/sets/S1-camino/stl/S1-TEE-G.stl

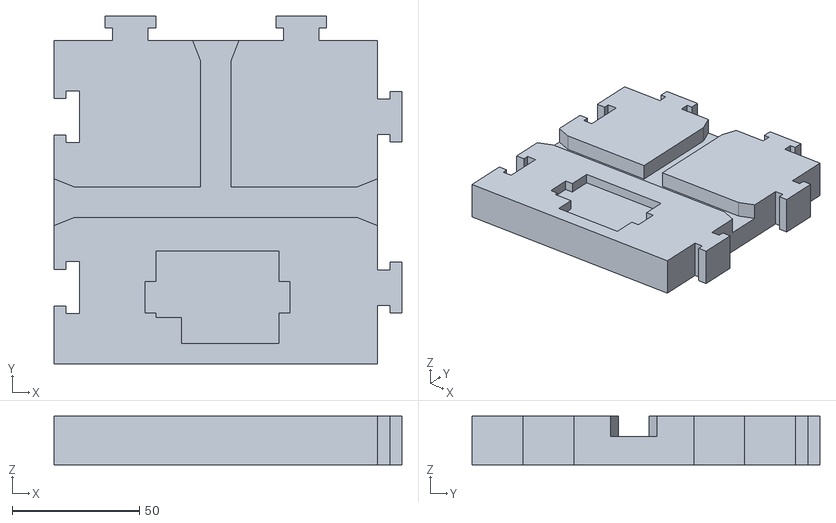
[picture p55: CAD file, 2026-10-30]
sets/S1-camino/stl/S1-TEE-G.stl
136.8 x 136.8 x 19.2
