FrankBetances/lua-construye/sets/S2-estacion-sonido/stl/K-PLACA-ESCUCHA.stl

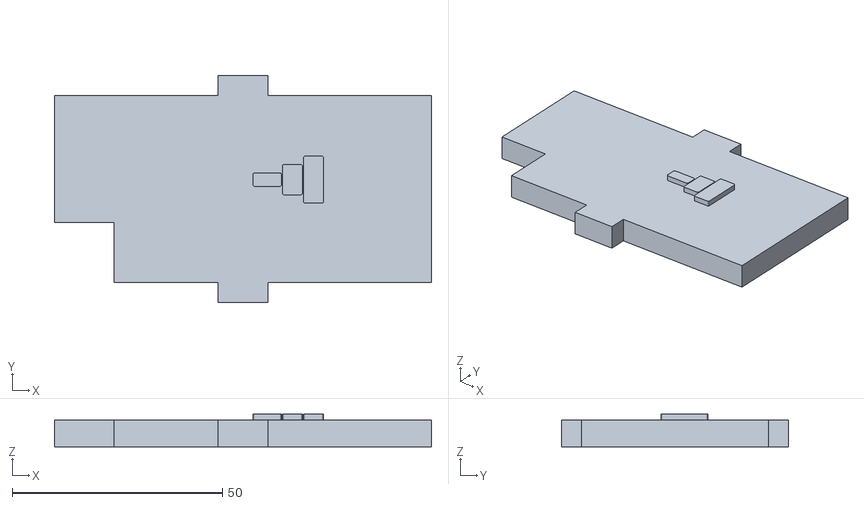
[picture p56: CAD file, 2026-10-29]
sets/S2-estacion-sonido/stl/K-PLACA-ESCUCHA.stl
89.6 x 54.0 x 7.80
