FrankBetances/lua-construye/sets/S4-maquina-soplo/stl/S4-MOL-JAULA-G.stl

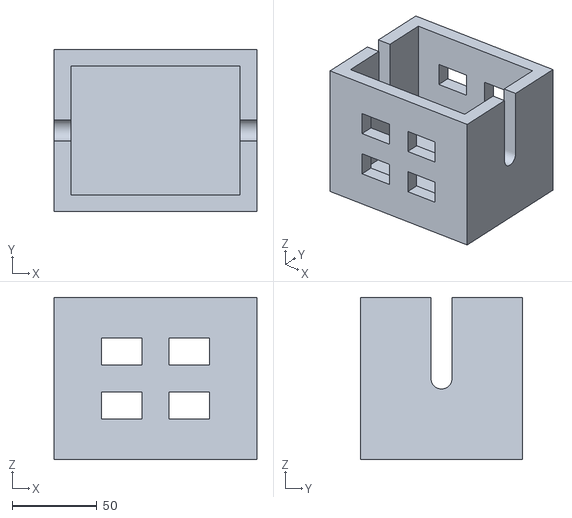
[picture p57: CAD file, 2026-10-29]
sets/S4-maquina-soplo/stl/S4-MOL-JAULA-G.stl
120.0 x 96.0 x 96.0
