FrankBetances/lua-construye/sets/S6-jardin/stl/S6-COP-G.stl

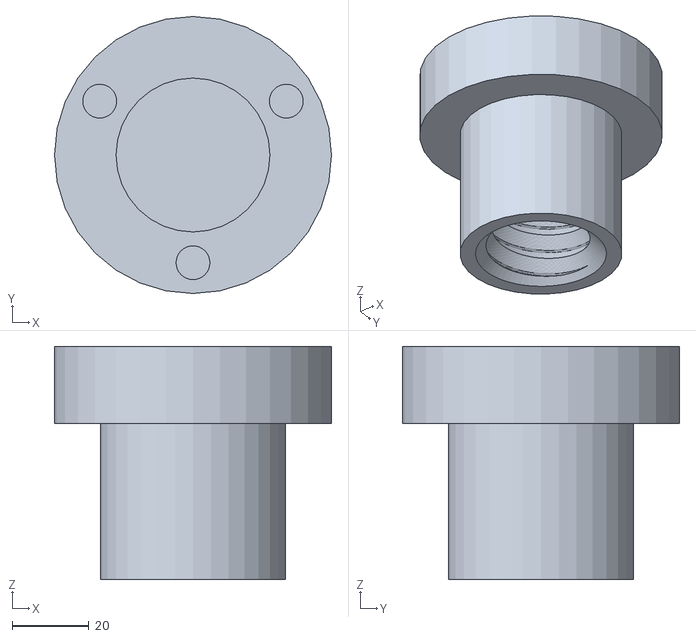
[picture p58: CAD file, 2026-10-29]
sets/S6-jardin/stl/S6-COP-G.stl
72.0 x 72.0 x 60.6
