FrankBetances/lua-construye/entrega/masque3d-sets-v1/P1-probeta-encaje/P1-MAC-G-025.stl

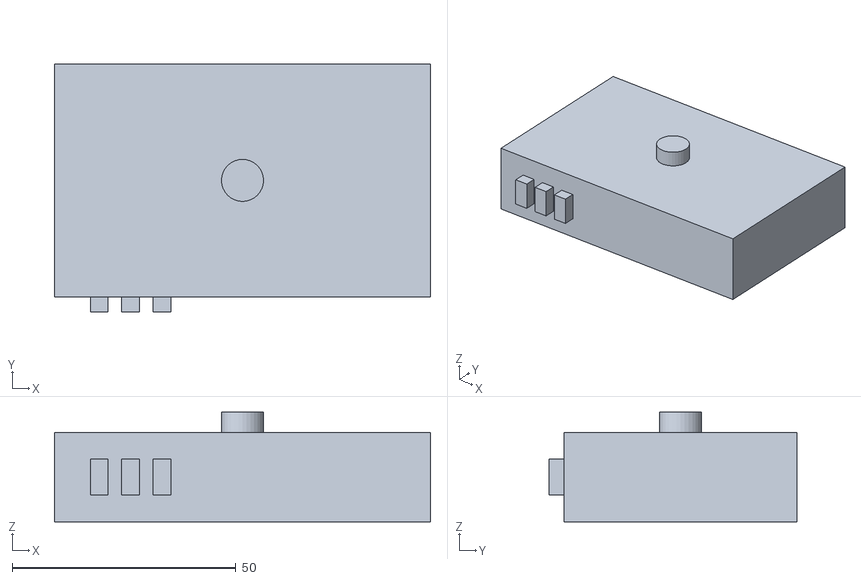
[picture p59: CAD file, 2026-10-30]
entrega/masque3d-sets-v1/P1-probeta-encaje/P1-MAC-G-025.stl
84.0 x 55.4 x 24.5
