FrankBetances/lua-construye/entrega/masque3d-sets-v1/S2-estacion-sonido/S2-RES-AZU-E-A.stl

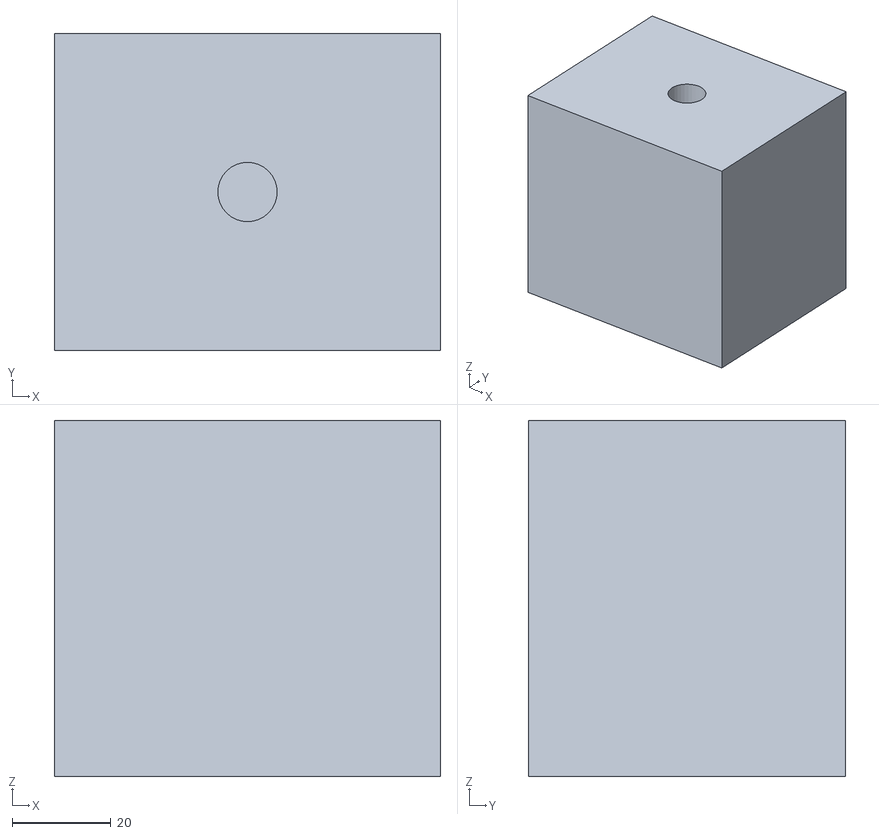
[picture p60: CAD file, 2026-10-30]
entrega/masque3d-sets-v1/S2-estacion-sonido/S2-RES-AZU-E-A.stl
78.0 x 64.0 x 72.0
