FrankBetances/lua-construye/entrega/masque3d-sets-v1/S3-laboratorio-rampas/S3-ESF-RUG-G.stl

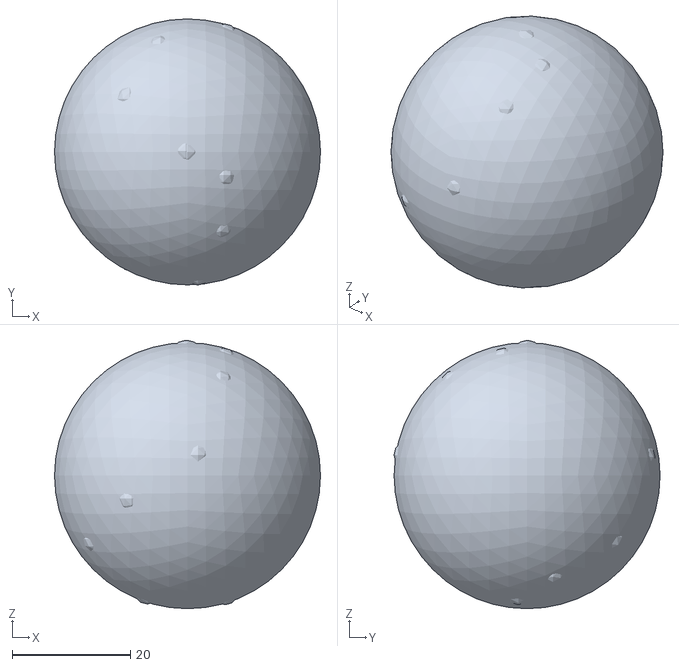
[picture p61: CAD file, 2026-10-30]
entrega/masque3d-sets-v1/S3-laboratorio-rampas/S3-ESF-RUG-G.stl
45.0 x 45.0 x 45.4
