FrankBetances/lua-construye/entrega/masque3d-sets-v1/S4-maquina-soplo/S4-COM-LIG-E.stl

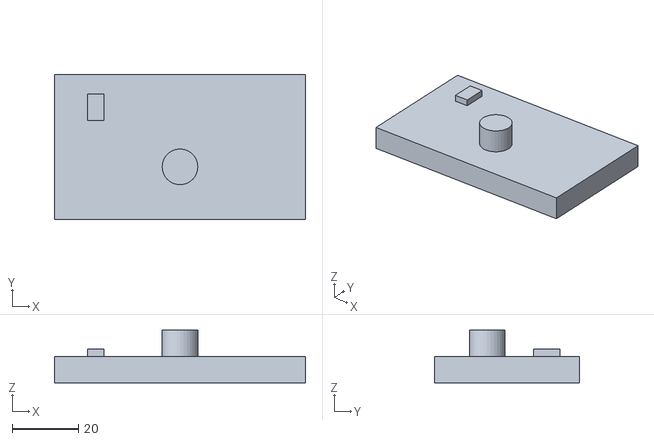
[picture p62: CAD file, 2026-10-30]
entrega/masque3d-sets-v1/S4-maquina-soplo/S4-COM-LIG-E.stl
76.0 x 44.0 x 16.0
