FrankBetances/lua-construye/entrega/masque3d-sets-v1/S5-puente-equilibrio/S5-MAS-60.stl

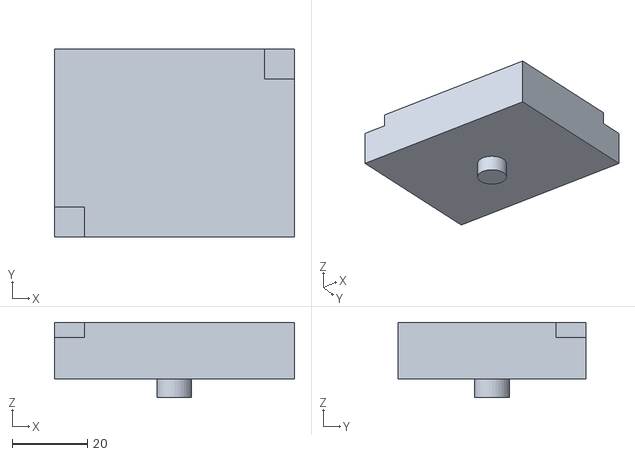
[picture p63: CAD file, 2026-10-30]
entrega/masque3d-sets-v1/S5-puente-equilibrio/S5-MAS-60.stl
64.0 x 50.0 x 20.1
