FrankBetances/lua-construye/entrega/masque3d-sets-v1/S6-jardin/S6-FRU-NAR.stl

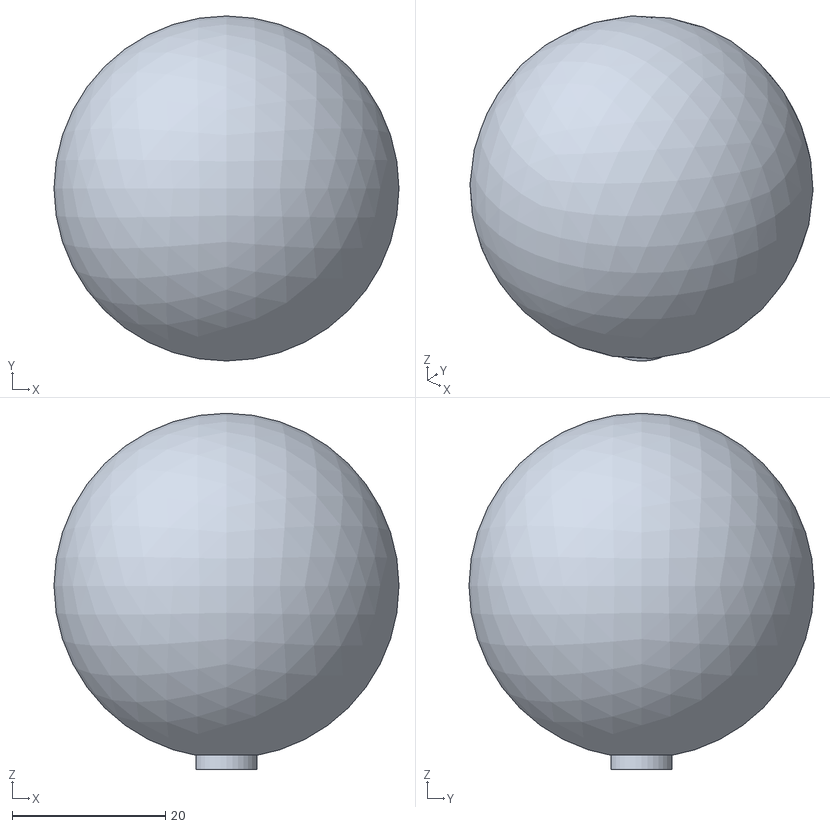
[picture p64: CAD file, 2026-10-30]
entrega/masque3d-sets-v1/S6-jardin/S6-FRU-NAR.stl
45.0 x 45.0 x 46.5
