FrankBetances/lua-construye/escenas-juego/escenas/S4-maquina-soplo.stl

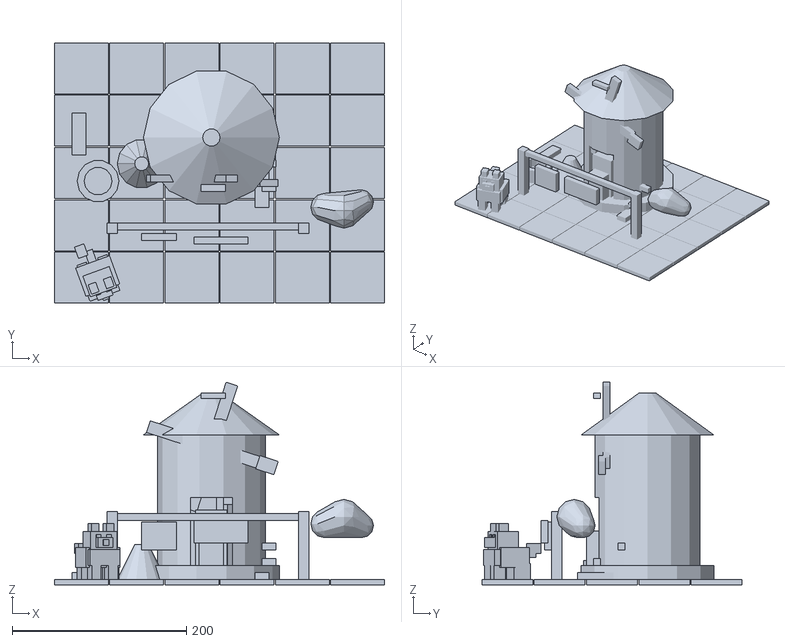
[picture p65: CAD file, 2026-10-29]
escenas-juego/escenas/S4-maquina-soplo.stl
378.6 x 298.6 x 232.4
