FrankBetances/lua-construye/sets/S4-maquina-soplo/stl/S4-ROT-JAULA-E.stl

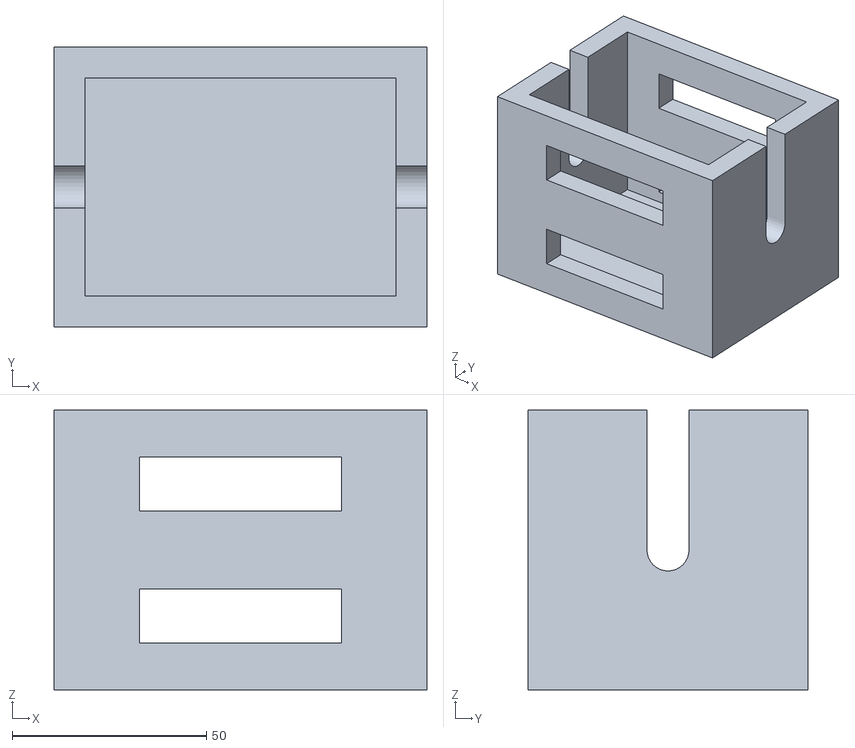
[picture p66: CAD file, 2026-10-29]
sets/S4-maquina-soplo/stl/S4-ROT-JAULA-E.stl
96.0 x 72.0 x 72.0
