FrankBetances/lua-construye/entrega/masque3d-sets-v1/S2-estacion-sonido/S2-BAL-BRAZO-E.stl

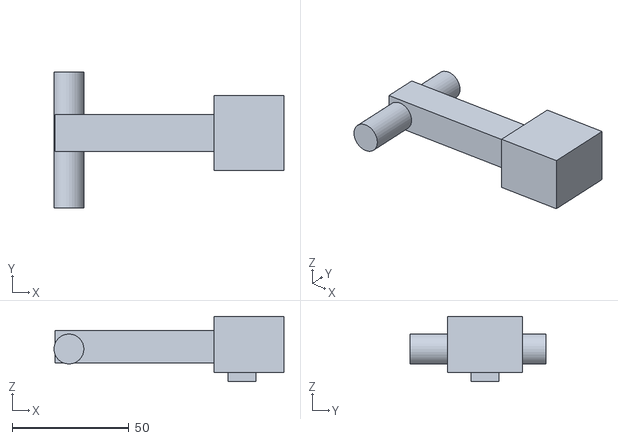
[picture p68: CAD file, 2026-10-30]
entrega/masque3d-sets-v1/S2-estacion-sonido/S2-BAL-BRAZO-E.stl
98.4 x 58.0 x 28.0
