FrankBetances/lua-construye/entrega/masque3d-sets-v1/S4-maquina-soplo/S4-COD-E.stl

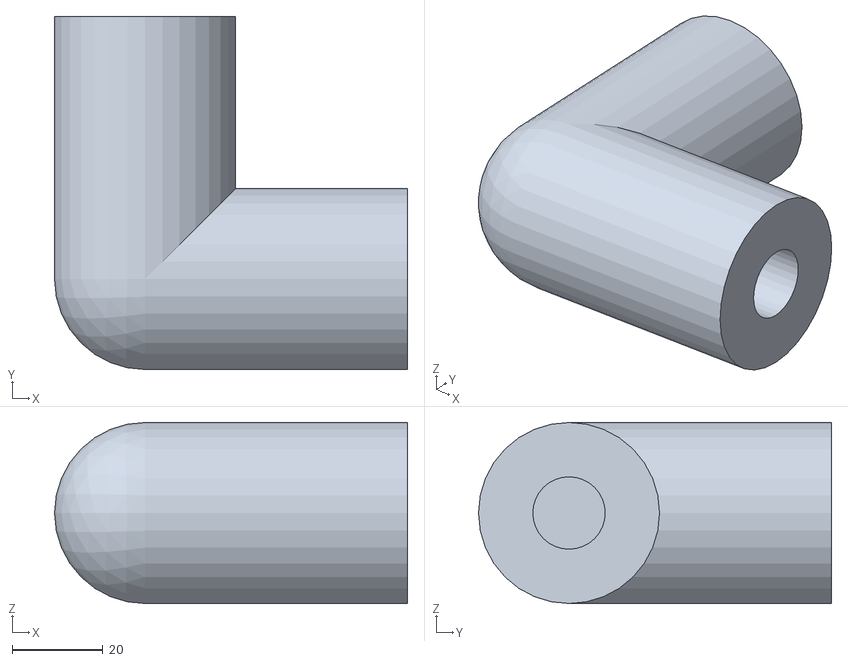
[picture p69: CAD file, 2026-10-30]
entrega/masque3d-sets-v1/S4-maquina-soplo/S4-COD-E.stl
78.0 x 78.0 x 40.0
