FrankBetances/lua-construye/entrega/masque3d-sets-v1/S5-puente-equilibrio/S5-PAS-G.stl

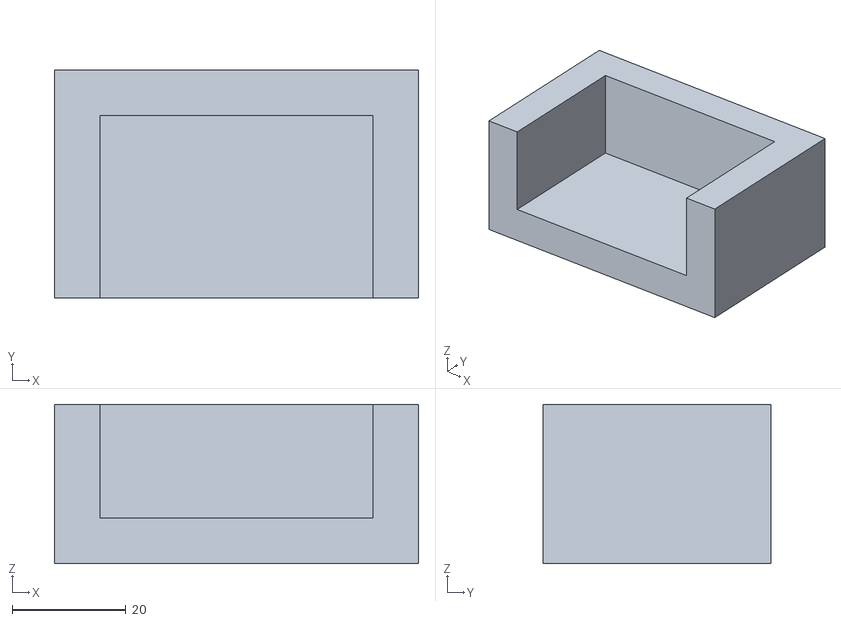
[picture p70: CAD file, 2026-10-30]
entrega/masque3d-sets-v1/S5-puente-equilibrio/S5-PAS-G.stl
64.0 x 40.0 x 28.0
