FrankBetances/lua-construye/entrega/masque3d-sets-v1/S6-jardin/S6-PRI-AZU.stl

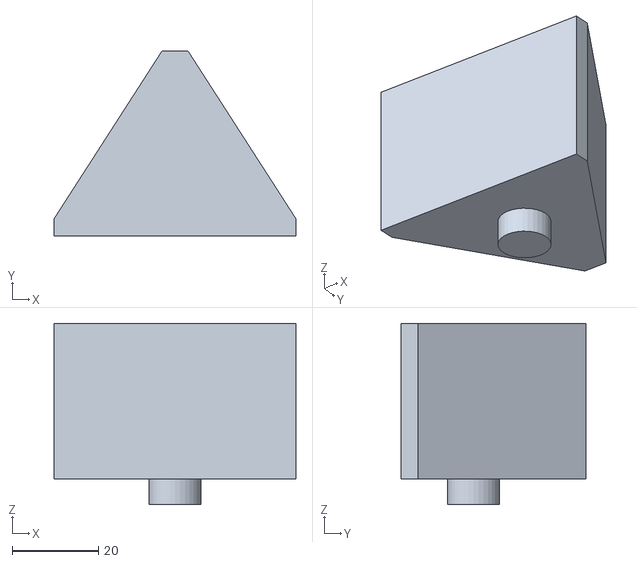
[picture p71: CAD file, 2026-10-30]
entrega/masque3d-sets-v1/S6-jardin/S6-PRI-AZU.stl
56.0 x 42.9 x 42.0
