FrankBetances/lua-construye/escenas-juego/escenas/S5-puente-equilibrio.stl

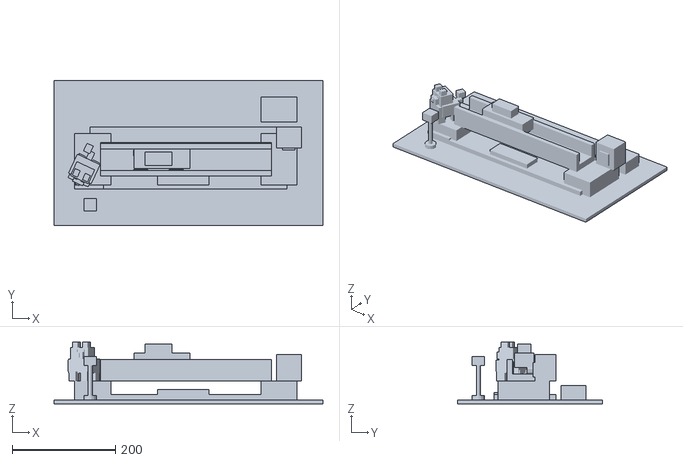
[picture p72: CAD file, 2026-10-29]
escenas-juego/escenas/S5-puente-equilibrio.stl
520.0 x 280.0 x 119.6
