FrankBetances/lua-construye/sets/S1-camino/stl/S1-REC-RUG-G.stl

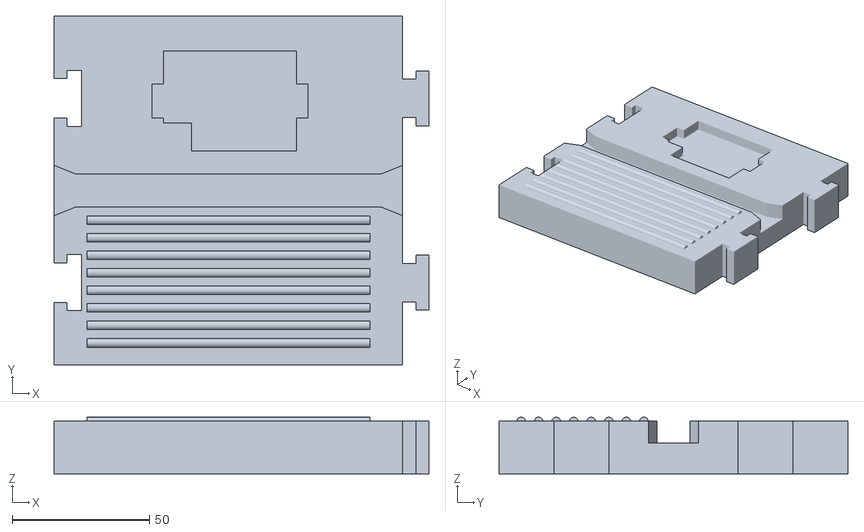
[picture p73: CAD file, 2026-10-30]
sets/S1-camino/stl/S1-REC-RUG-G.stl
136.8 x 127.2 x 20.7
