FrankBetances/lua-construye/sets/S2-estacion-sonido/stl/S2-RES-AMA-E-B.stl

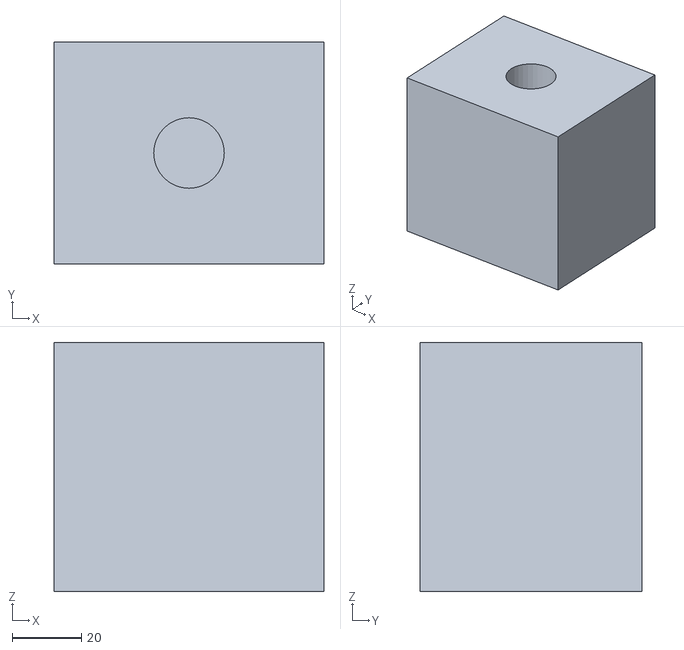
[picture p74: CAD file, 2026-10-29]
sets/S2-estacion-sonido/stl/S2-RES-AMA-E-B.stl
78.0 x 64.0 x 72.0
