FrankBetances/lua-construye/sets/S3-laboratorio-rampas/stl/S3-PIL-4-G.stl

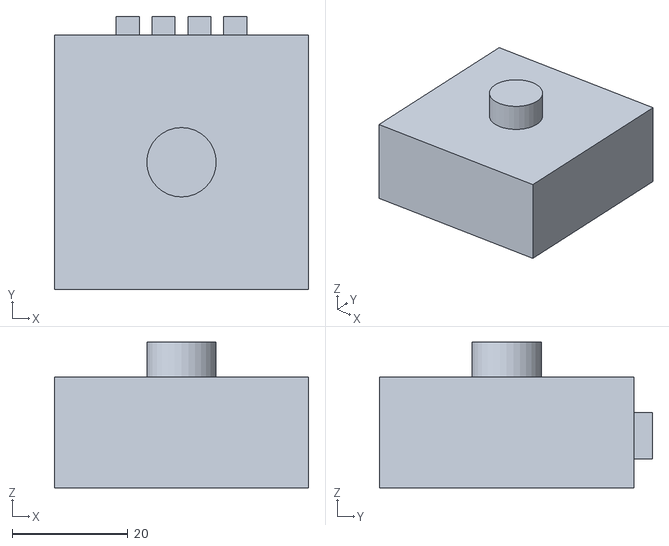
[picture p75: CAD file, 2026-10-28]
sets/S3-laboratorio-rampas/stl/S3-PIL-4-G.stl
44.0 x 47.2 x 25.2
