FrankBetances/lua-construye/sets/S6-jardin/stl/S6-TAL-G.stl

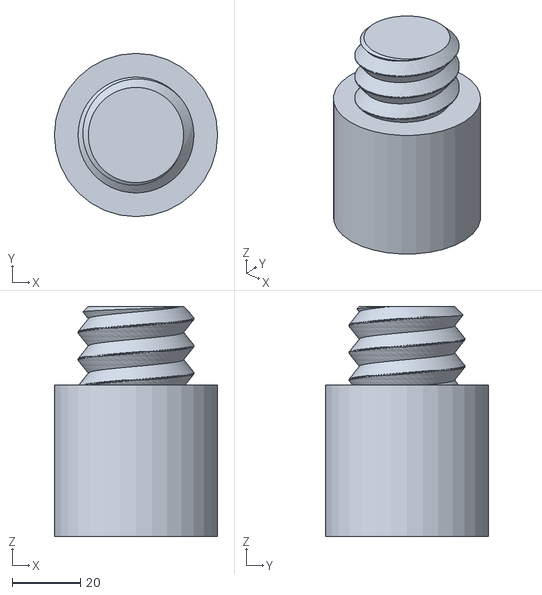
[picture p76: CAD file, 2026-10-29]
sets/S6-jardin/stl/S6-TAL-G.stl
48.0 x 48.0 x 67.6
