FrankBetances/lua-construye/entrega/masque3d-sets-v1/S3-laboratorio-rampas/S3-RAM-G.stl

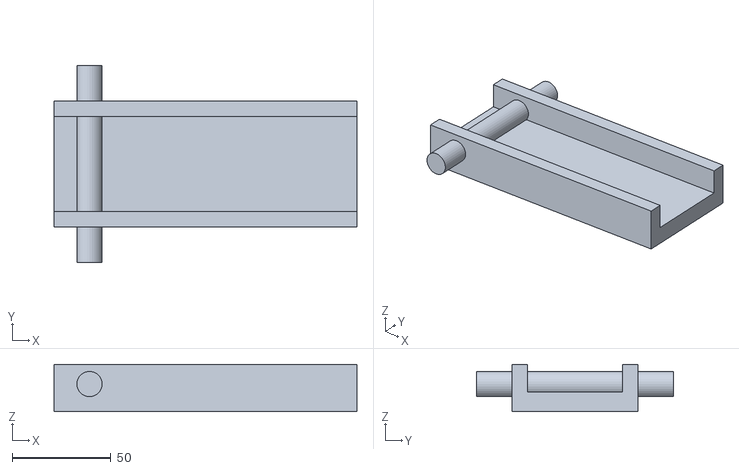
[picture p78: CAD file, 2026-10-30]
entrega/masque3d-sets-v1/S3-laboratorio-rampas/S3-RAM-G.stl
153.6 x 100.0 x 24.0
