FrankBetances/lua-construye/entrega/masque3d-sets-v1/S5-puente-equilibrio/S5-MAS-20.stl

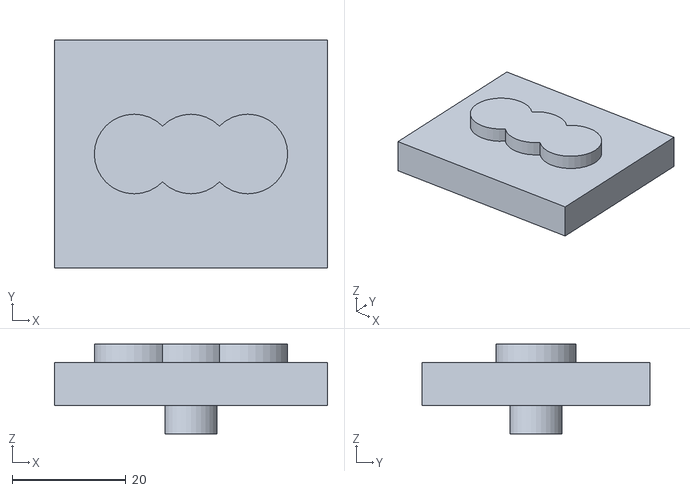
[picture p79: CAD file, 2026-10-30]
entrega/masque3d-sets-v1/S5-puente-equilibrio/S5-MAS-20.stl
48.0 x 40.0 x 15.8
