FrankBetances/lua-construye/entrega/masque3d-sets-v1/S6-jardin/S6-SIL-ARB.stl

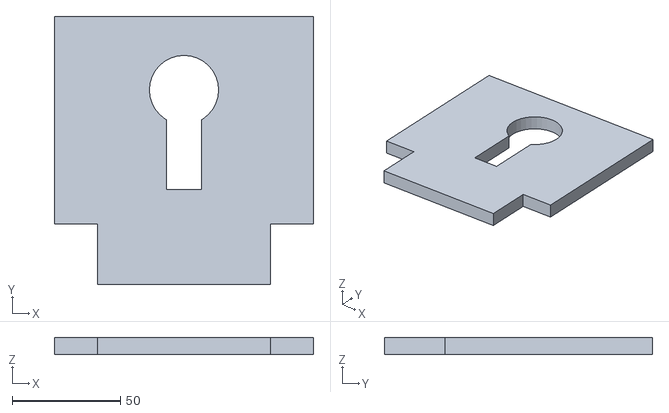
[picture p80: CAD file, 2026-10-30]
entrega/masque3d-sets-v1/S6-jardin/S6-SIL-ARB.stl
120.0 x 124.0 x 8.00
