FrankBetances/lua-construye/escenas-juego/escenas/S0-kit-lua.stl

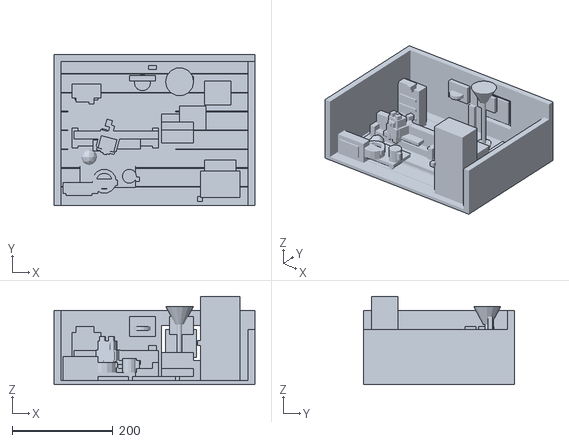
[picture p81: CAD file, 2026-10-29]
escenas-juego/escenas/S0-kit-lua.stl
400.0 x 300.0 x 176.0
