FrankBetances/lua-construye/entrega/masque3d-sets-v1/00-comun/S3-PIL-6-G.stl

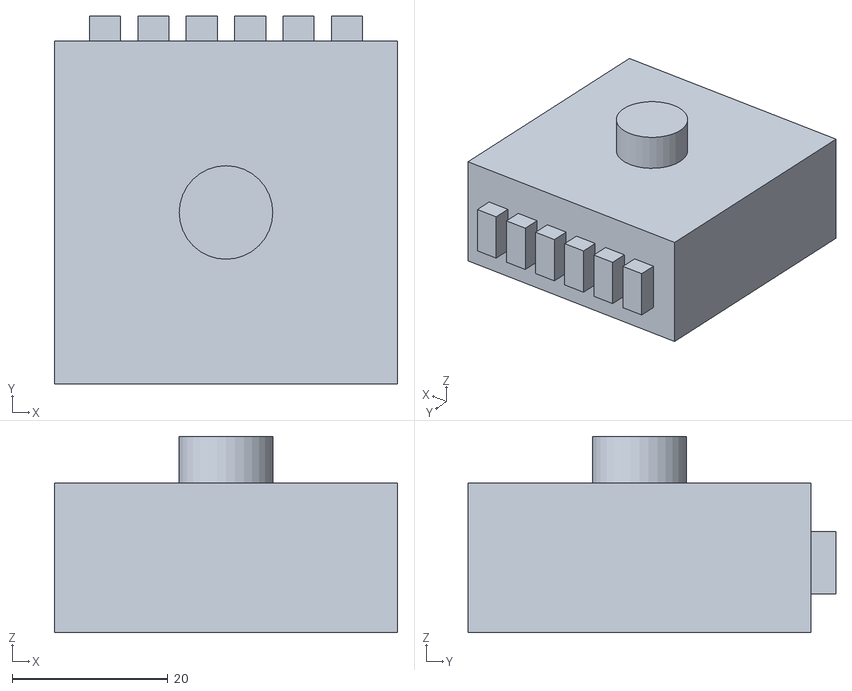
[picture p83: CAD file, 2026-10-30]
entrega/masque3d-sets-v1/00-comun/S3-PIL-6-G.stl
44.0 x 47.2 x 25.2
