FrankBetances/lua-construye/entrega/masque3d-sets-v1/S1-camino/S1-CMD-AVA-G.stl

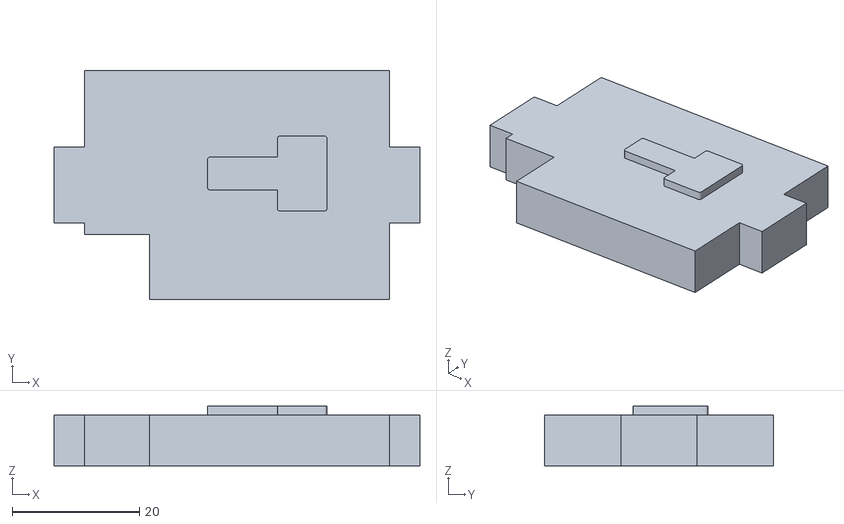
[picture p84: CAD file, 2026-10-30]
entrega/masque3d-sets-v1/S1-camino/S1-CMD-AVA-G.stl
57.6 x 36.0 x 9.40
