FrankBetances/lua-construye/entrega/masque3d-sets-v1/S3-laboratorio-rampas/S3-FRI-G.stl

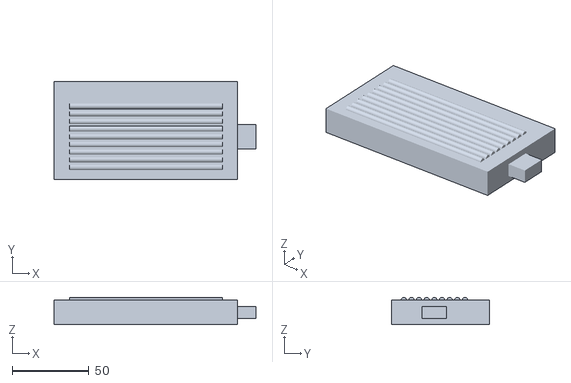
[picture p85: CAD file, 2026-10-30]
entrega/masque3d-sets-v1/S3-laboratorio-rampas/S3-FRI-G.stl
132.0 x 64.0 x 17.8
