FrankBetances/lua-construye/entrega/masque3d-sets-v1/S5-puente-equilibrio/S5-MAS-40.stl

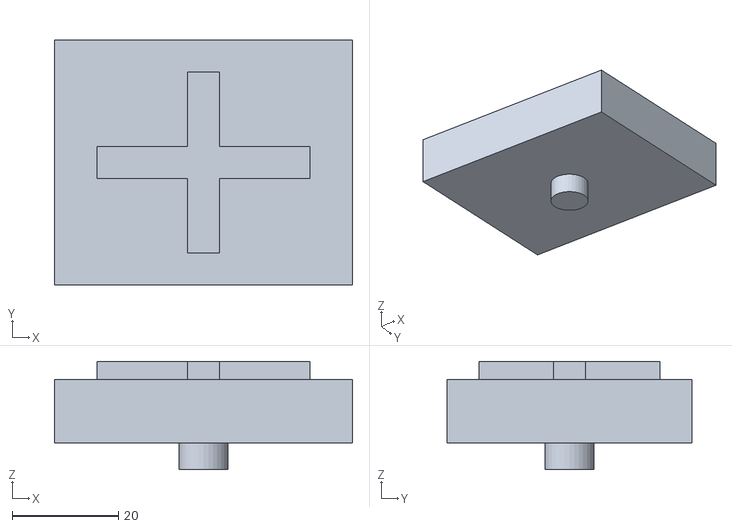
[picture p86: CAD file, 2026-10-30]
entrega/masque3d-sets-v1/S5-puente-equilibrio/S5-MAS-40.stl
56.0 x 46.0 x 20.4
