FrankBetances/lua-construye/entrega/masque3d-sets-v1/S6-jardin/S6-PRI-AMA.stl

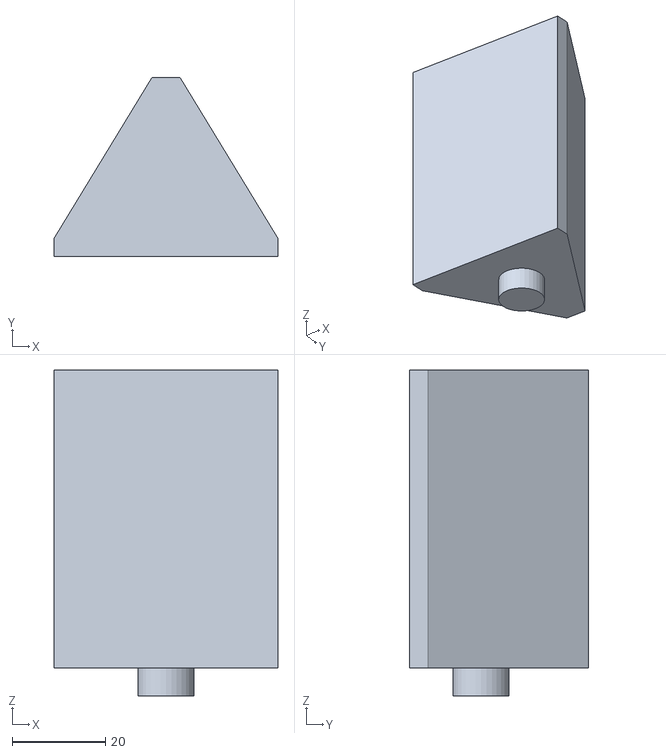
[picture p87: CAD file, 2026-10-30]
entrega/masque3d-sets-v1/S6-jardin/S6-PRI-AMA.stl
48.0 x 38.5 x 70.0
