FrankBetances/lua-construye/escenas-juego/escenas/S7-granja.stl

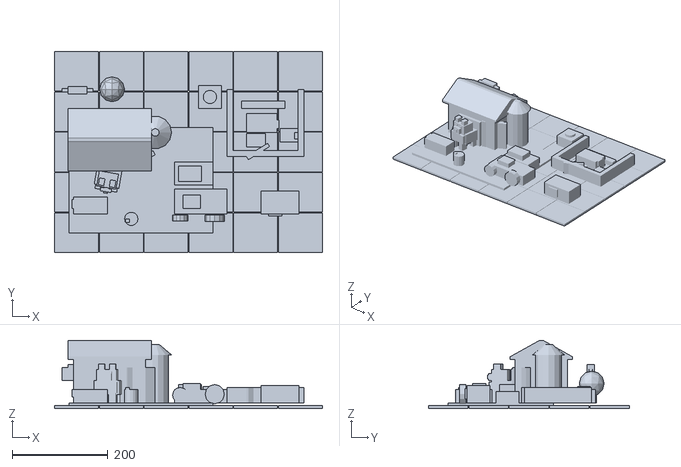
[picture p88: CAD file, 2026-10-29]
escenas-juego/escenas/S7-granja.stl
558.6 x 418.6 x 142.0
