FrankBetances/lua-construye/sets/S2-estacion-sonido/stl/S2-BAL-BASE-E.stl

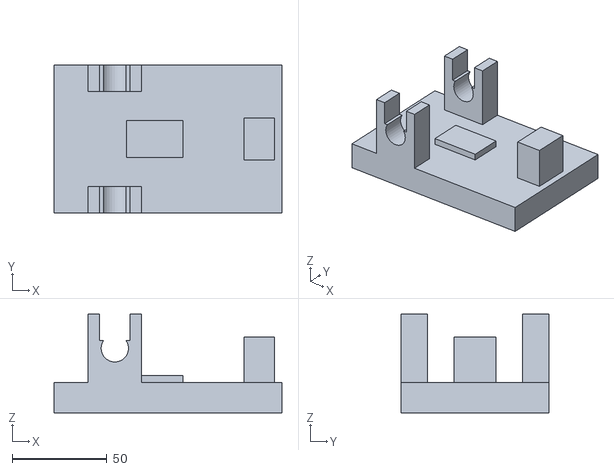
[picture p89: CAD file, 2026-10-29]
sets/S2-estacion-sonido/stl/S2-BAL-BASE-E.stl
120.0 x 78.0 x 52.0
