FrankBetances/lua-construye/sets/S4-maquina-soplo/stl/S4-MOL-ASPAS-G.stl

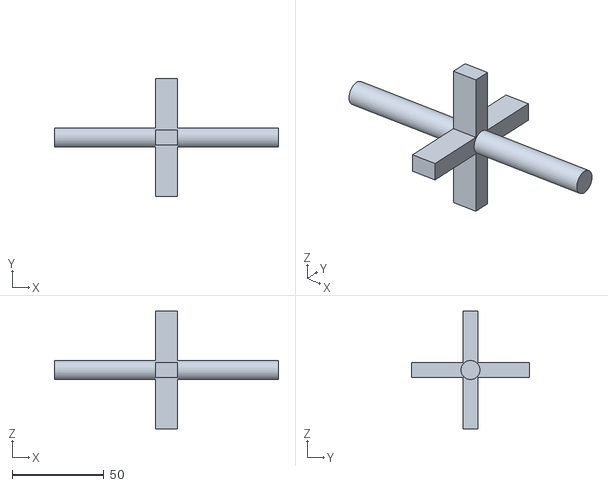
[picture p90: CAD file, 2026-10-29]
sets/S4-maquina-soplo/stl/S4-MOL-ASPAS-G.stl
122.0 x 64.0 x 64.0
