FrankBetances/lua-construye/sets/S6-jardin/stl/S6-FLO-G.stl

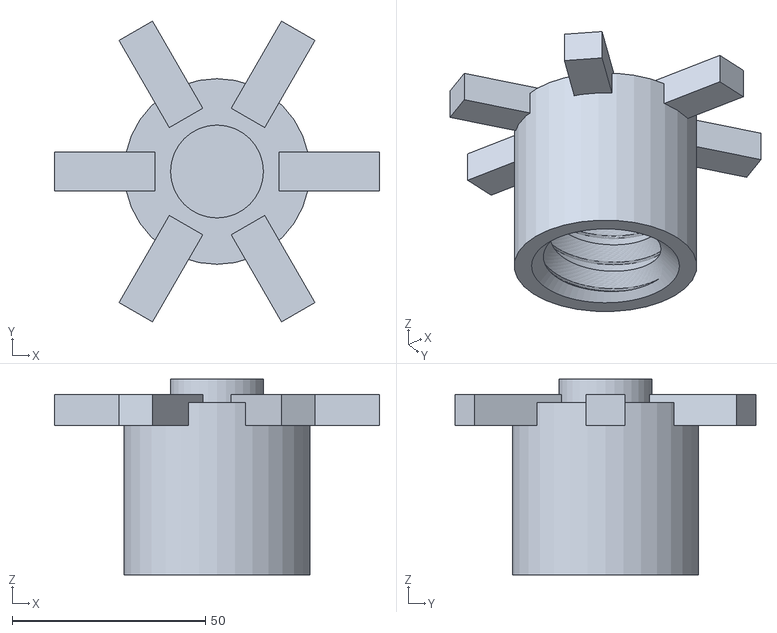
[picture p91: CAD file, 2026-10-29]
sets/S6-jardin/stl/S6-FLO-G.stl
84.0 x 77.7 x 50.6
