FrankBetances/lua-construye/entrega/masque3d-sets-v1/S3-laboratorio-rampas/S3-BIS-G.stl

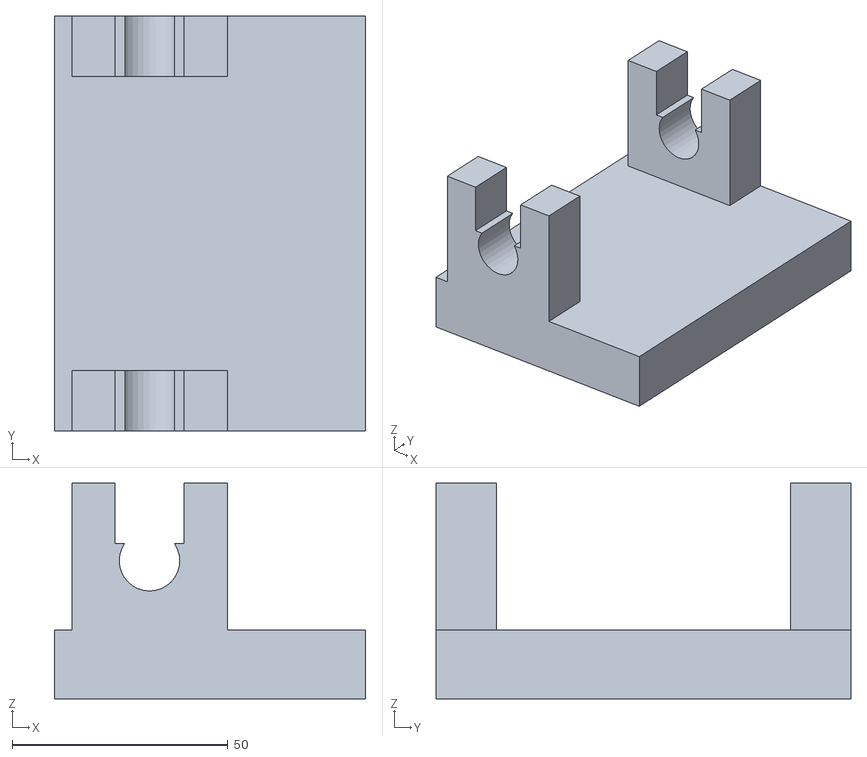
[picture p92: CAD file, 2026-10-30]
entrega/masque3d-sets-v1/S3-laboratorio-rampas/S3-BIS-G.stl
72.0 x 96.0 x 50.0
