FrankBetances/lua-construye/escenas-juego/escenas/S3-laboratorio-rampas.stl

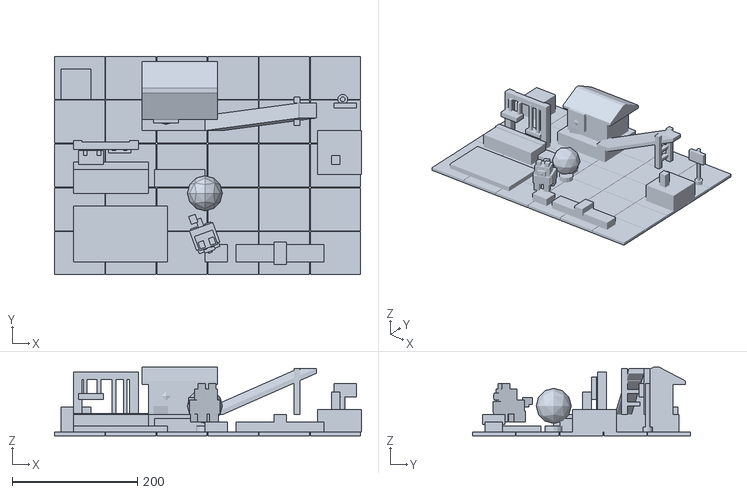
[picture p93: CAD file, 2026-10-29]
escenas-juego/escenas/S3-laboratorio-rampas.stl
490.0 x 348.6 x 110.0
