FrankBetances/lua-construye/entrega/masque3d-sets-v1/S4-maquina-soplo/S4-COM-PES-E.stl

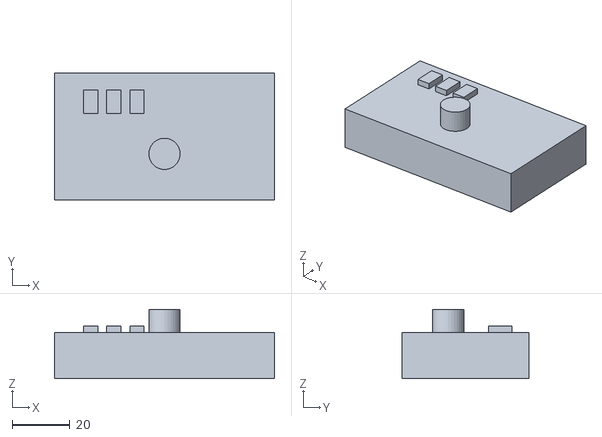
[picture p94: CAD file, 2026-10-30]
entrega/masque3d-sets-v1/S4-maquina-soplo/S4-COM-PES-E.stl
76.0 x 44.0 x 24.0
