FrankBetances/lua-construye/escenas-juego/escenas/S1-camino.stl

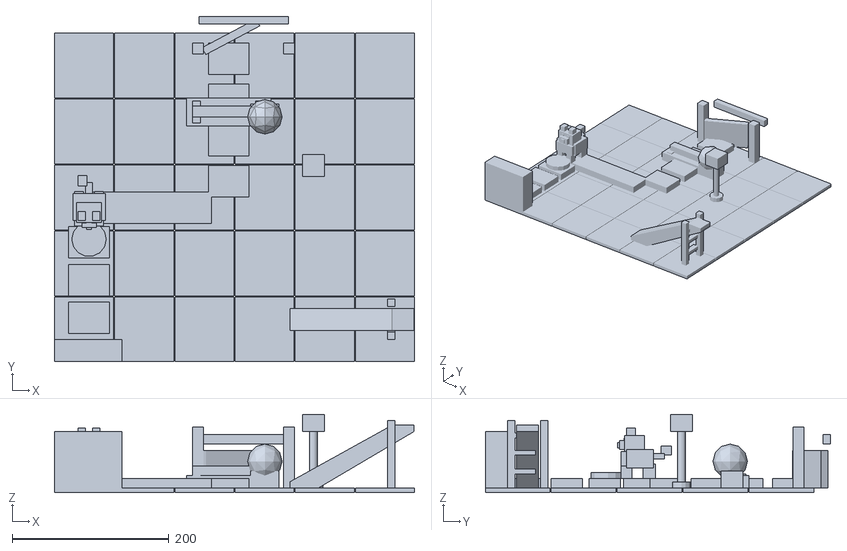
[picture p95: CAD file, 2026-10-29]
escenas-juego/escenas/S1-camino.stl
458.6 x 440.0 x 100.0
