FrankBetances/lua-construye/entrega/masque3d-sets-v1/S6-jardin/S6-FRU-MAN.stl

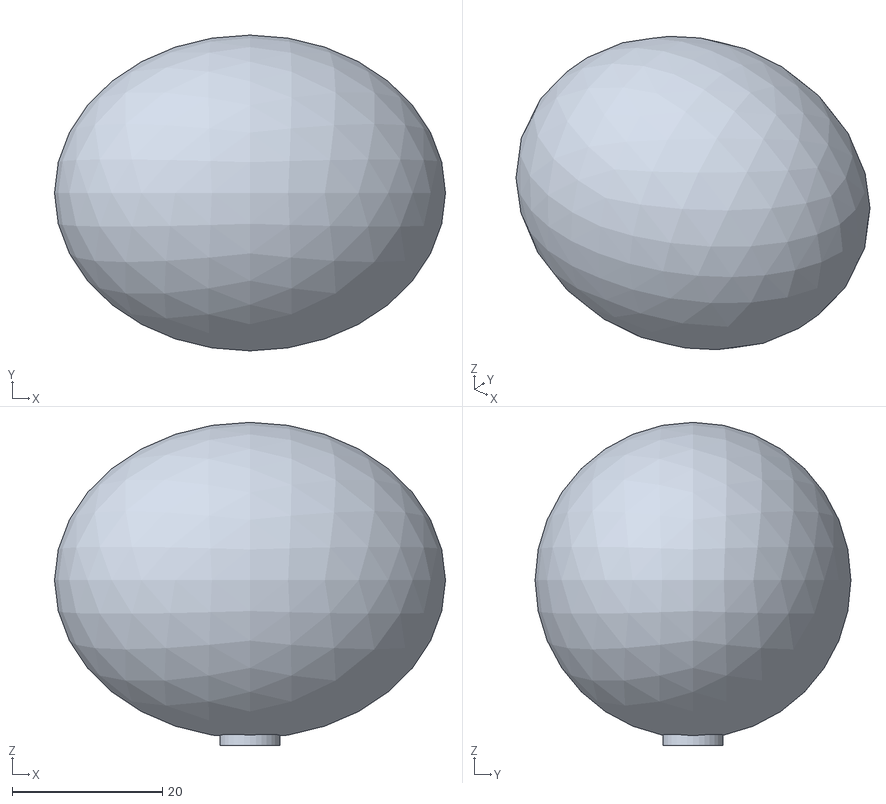
[picture p96: CAD file, 2026-10-30]
entrega/masque3d-sets-v1/S6-jardin/S6-FRU-MAN.stl
52.0 x 42.0 x 43.0
