FrankBetances/lua-construye/entrega/masque3d-sets-v1/S6-jardin/S6-TIE-G.stl

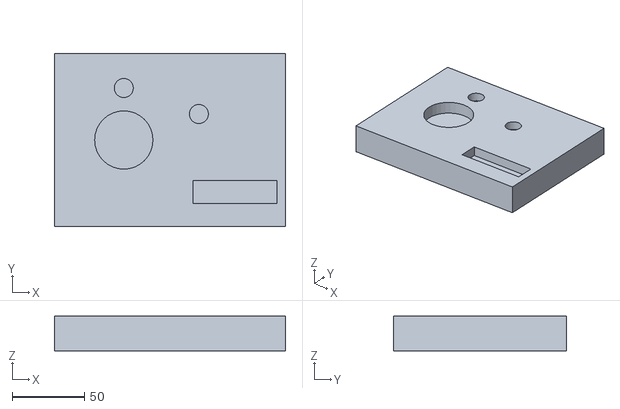
[picture p97: CAD file, 2026-10-30]
entrega/masque3d-sets-v1/S6-jardin/S6-TIE-G.stl
160.0 x 120.0 x 24.0
