FrankBetances/lua-construye/(list of files, cad)

Other CAD files:
sets/S0-kit-lua/stl/K-PATIN-G.stl
sets/S3-laboratorio-rampas/stl/K-PLACA-RECEPTOR.stl
sets/S5-puente-equilibrio/stl/S5-FUL-G.stl
entrega/masque3d-sets-v1/00-comun/K-PLACA-NIVEL.stl
entrega/masque3d-sets-v1/S1-camino/S1-DEST-CAMA.stl
sets/S2-estacion-sonido/stl/S2-RES-AZU-E-B.stl
sets/S3-laboratorio-rampas/stl/S3-CUR-PER-G.stl
sets/S5-puente-equilibrio/stl/K-PLACA-NIVEL.stl
sets/S6-jardin/stl/S6-FRU-MANZ.stl
entrega/masque3d-sets-v1/00-comun/S3-PIL-1-G.stl
entrega/masque3d-sets-v1/S1-camino/S1-CUR-G.stl
entrega/masque3d-sets-v1/S3-laboratorio-rampas/S3-ESF-LIS-G.stl
sets/S0-kit-lua/stl/K-PLACA-FRONTAL.stl
sets/S4-maquina-soplo/stl/K-PLACA-FRONTAL.stl
sets/S5-puente-equilibrio/stl/S3-PIL-2-G.stl
entrega/masque3d-sets-v1/00-comun/K-PLACA-ESCUCHA.stl
entrega/masque3d-sets-v1/S1-camino/S1-DEST-PARQUE.stl
entrega/masque3d-sets-v1/S2-estacion-sonido/S2-RES-AMA-E-C.stl
entrega/masque3d-sets-v1/S4-maquina-soplo/S4-MOL-JAULA-G.stl
sets/S0-kit-lua/stl/K-PLACA-INICIO.stl
sets/S1-camino/stl/K-PATIN-G.stl
sets/S2-estacion-sonido/stl/S2-RES-AMA-E-C.stl
sets/S4-maquina-soplo/stl/S4-ROT-ASPAS-E.stl
sets/S5-puente-equilibrio/stl/S5-PAS-G.stl
sets/S6-jardin/stl/S6-PRI-AZU.stl
entrega/masque3d-sets-v1/P1-probeta-encaje/P1-HEM-G-015.stl
entrega/masque3d-sets-v1/S2-estacion-sonido/S2-RES-AMA-E-A.stl
entrega/masque3d-sets-v1/S4-maquina-soplo/S4-ROT-JAULA-E.stl
sets/S0-kit-lua/stl/K-PLACA-JARDIN.stl
sets/S1-camino/stl/K-PLACA-INICIO.stl
sets/S3-laboratorio-rampas/stl/S3-ESF-RUG-G.stl
sets/S5-puente-equilibrio/stl/S5-MAS-20.stl
entrega/masque3d-sets-v1/00-comun/K-PLACA-FRONTAL.stl
entrega/masque3d-sets-v1/P1-probeta-encaje/P1-MAC-E-015.stl
entrega/masque3d-sets-v1/S2-estacion-sonido/S2-BAL-BASE-E.stl
entrega/masque3d-sets-v1/S4-maquina-soplo/S4-MOL-ASPAS-G.stl
entrega/masque3d-sets-v1/S6-jardin/S6-FLO-G.stl
sets/S0-kit-lua/stl/K-PLACA-NIVEL.stl
sets/S1-camino/stl/S1-CMD-PAR-G.stl
sets/S2-estacion-sonido/stl/S2-RES-ROJ-E-B.stl
sets/S3-laboratorio-rampas/stl/S3-REC-G.stl
sets/S4-maquina-soplo/stl/S4-CAN-E.stl
sets/S5-puente-equilibrio/stl/S5-VIG-G.stl
sets/S6-jardin/stl/S6-SIL-ARB.stl
entrega/masque3d-sets-v1/00-comun/K-PLACA-INICIO.stl
entrega/masque3d-sets-v1/P1-probeta-encaje/P1-HEM-E-015.stl
entrega/masque3d-sets-v1/S1-camino/S1-CMD-SAL-G.stl
entrega/masque3d-sets-v1/S2-estacion-sonido/S2-RES-AZU-E-B.stl
entrega/masque3d-sets-v1/S6-jardin/S6-COP-G.stl
sets/S0-kit-lua/stl/K-PLACA-META.stl
sets/S1-camino/stl/K-PLACA-META.stl
sets/S2-estacion-sonido/stl/S2-RES-ROJ-E-C.stl
sets/S3-laboratorio-rampas/stl/S3-BIS-G.stl
sets/S4-maquina-soplo/stl/S4-COD-E.stl
sets/S5-puente-equilibrio/stl/S3-PIL-5-G.stl
sets/S6-jardin/stl/S6-SEM-G.stl
entrega/masque3d-sets-v1/00-comun/K-PLACA-JARDIN.stl
entrega/masque3d-sets-v1/P1-probeta-encaje/P1-MAC-G-020.stl
entrega/masque3d-sets-v1/S2-estacion-sonido/S2-RES-ROJ-E-A.stl
sets/S0-kit-lua/stl/K-PLACA-RECEPTOR.stl
sets/S1-camino/stl/S1-CMD-AVA-G.stl
sets/S2-estacion-sonido/stl/S2-RES-AMA-E-A.stl
sets/S3-laboratorio-rampas/stl/S3-PIL-5-G.stl
sets/S4-maquina-soplo/stl/S4-COM-LIG-E.stl
sets/S5-puente-equilibrio/stl/S3-PIL-6-G.stl
sets/S6-jardin/stl/S6-PRI-AMA.stl
entrega/masque3d-sets-v1/00-comun/S3-PIL-3-G.stl
entrega/masque3d-sets-v1/P1-probeta-encaje/P1-HEM-E-025.stl
entrega/masque3d-sets-v1/S1-camino/S1-CMD-PAR-G.stl
entrega/masque3d-sets-v1/S2-estacion-sonido/S2-RES-AMA-E-B.stl
entrega/masque3d-sets-v1/00-comun/K-PLACA-META.stl
entrega/masque3d-sets-v1/00-comun/K-PLACA-RECEPTOR.stl
entrega/masque3d-sets-v1/00-comun/S3-PIL-4-G.stl
entrega/masque3d-sets-v1/00-comun/S3-PIL-5-G.stl
entrega/masque3d-sets-v1/P1-probeta-encaje/P1-HEM-G-025.stl
entrega/masque3d-sets-v1/P1-probeta-encaje/P1-MAC-E-020.stl
entrega/masque3d-sets-v1/S2-estacion-sonido/S2-RAS-E.stl
entrega/masque3d-sets-v1/S2-estacion-sonido/S2-RES-AZU-E-C.stl
entrega/masque3d-sets-v1/S2-estacion-sonido/S2-RES-ROJ-E-B.stl
entrega/masque3d-sets-v1/S6-jardin/S6-FRU-MANZ.stl
entrega/masque3d-sets-v1/S6-jardin/S6-TAL-G.stl
sets/P1-probeta-encaje/stl/P1-HEM-E-015.stl
sets/P1-probeta-encaje/stl/P1-HEM-E-020.stl
sets/P1-probeta-encaje/stl/P1-HEM-E-025.stl
sets/P1-probeta-encaje/stl/P1-HEM-G-015.stl
sets/P1-probeta-encaje/stl/P1-HEM-G-020.stl
sets/P1-probeta-encaje/stl/P1-HEM-G-025.stl
sets/P1-probeta-encaje/stl/P1-MAC-E-015.stl
sets/P1-probeta-encaje/stl/P1-MAC-E-020.stl
sets/P1-probeta-encaje/stl/P1-MAC-E-025.stl
sets/P1-probeta-encaje/stl/P1-MAC-G-015.stl
sets/P1-probeta-encaje/stl/P1-MAC-G-020.stl
sets/P1-probeta-encaje/stl/P1-MAC-G-025.stl
sets/S0-kit-lua/stl/K-COLA-G.stl
sets/S0-kit-lua/stl/K-LOMO-G.stl
sets/S0-kit-lua/stl/K-PATA-DEL-G.stl
sets/S0-kit-lua/stl/K-PATA-TRA-G.stl
sets/S0-kit-lua/stl/K-TRONCO-G.stl
sets/S1-camino/stl/S1-CMD-GIR-G.stl
sets/S1-camino/stl/S1-CMD-SAL-G.stl
sets/S1-camino/stl/S1-CUR-G.stl
sets/S1-camino/stl/S1-DEST-CAMA.stl
sets/S1-camino/stl/S1-DEST-PARQUE.stl
sets/S2-estacion-sonido/stl/S2-BAL-BRAZO-E.stl
sets/S2-estacion-sonido/stl/S2-ESP-E.stl
sets/S2-estacion-sonido/stl/S2-RAS-E.stl
sets/S2-estacion-sonido/stl/S2-RES-AZU-E-A.stl
sets/S2-estacion-sonido/stl/S2-RES-AZU-E-C.stl
sets/S2-estacion-sonido/stl/S2-RES-ROJ-E-A.stl
sets/S2-estacion-sonido/stl/S3-PIL-1-G.stl
sets/S2-estacion-sonido/stl/S3-PIL-2-G.stl
sets/S2-estacion-sonido/stl/S3-PIL-5-G.stl
sets/S2-estacion-sonido/stl/S3-PIL-6-G.stl
sets/S3-laboratorio-rampas/stl/S3-ESF-LIS-G.stl
sets/S3-laboratorio-rampas/stl/S3-FRI-G.stl
sets/S3-laboratorio-rampas/stl/S3-PIL-1-G.stl
sets/S3-laboratorio-rampas/stl/S3-PIL-2-G.stl
sets/S3-laboratorio-rampas/stl/S3-PIL-6-G.stl
sets/S3-laboratorio-rampas/stl/S3-RAM-G.stl
sets/S4-maquina-soplo/stl/S4-COM-PES-E.stl
sets/S5-puente-equilibrio/stl/S3-PIL-1-G.stl
sets/S5-puente-equilibrio/stl/S5-MAS-40.stl
sets/S5-puente-equilibrio/stl/S5-MAS-60.stl
sets/S6-jardin/stl/K-PLACA-JARDIN.stl
sets/S6-jardin/stl/S6-FRU-MAN.stl
sets/S6-jardin/stl/S6-FRU-NAR.stl
sets/S6-jardin/stl/S6-SIL-LUN.stl
sets/S6-jardin/stl/S6-TIE-G.stl
