FrankBetances/lua-construye/sets/S1-camino/manual/manual.pdf

## El Camino de Lúa

Tarjeta recta del Set 1. Manual para el adulto que media.

Esto no es un diagnóstico ni un tratamiento. La revisión de medidas no es un certificado EN 71-1 de laboratorio. No se declara conformidad.
Isto non é un diagnóstico nin un tratamento. A revisión de medidas non é un certificado EN 71-1 de laboratorio. Non se declara conformidade.

### Quién hace qué

El niño mueve los bloques. El adulto sostiene la tableta. La criatura no toca la pantalla.

O neno move os bloques. O adulto sostén a tableta. A criatura non toca a pantalla.

La izquierda y la derecha son las de Lúa, la gata negra. El niño la mira desde atrás, así no tiene que hacer un giro en espejo.

Si hay un reconocimiento al terminar, es para el adulto que acompañó. Nunca es un premio para el niño.

### Piezas de este ejemplo

Código | Pieza | Cantidad
S1-REC-LIS-G | Baldosa recta lisa (ondas suaves) | 3
S1-REC-RUG-G | Baldosa recta rugosa (estriada) | 3
S1-CUR-G | Curva de 90° | 4
S1-TEE-G | Intersección en T | 2
S1-CMD-AVA-G | Ficha de comando avanza | 1
S1-CMD-PAR-G | Ficha de comando para | 1
S1-CMD-GIR-G | Ficha de comando gira | 1
S1-CMD-SAL-G | Ficha de comando salta | 1
S1-DEST-PARQUE | Placa de destino parque | 1
S1-DEST-CAMA | Placa de destino cama | 1
K-ZOCALO-G | Zócalo universal | 1
K-PLACA-INICIO | Placa de identidad INICIO | 1
K-PLACA-META | Placa de identidad META | 1
K-PATIN-G | Patín guía | 1

La hipótesis de planta (4 × 31,80 mm) está declarada en el BOM: SETS no da el ancho del cuerpo de Lúa.

### Montaje

Cada pieza baja. El vector de inserción es (0, 0, −1).

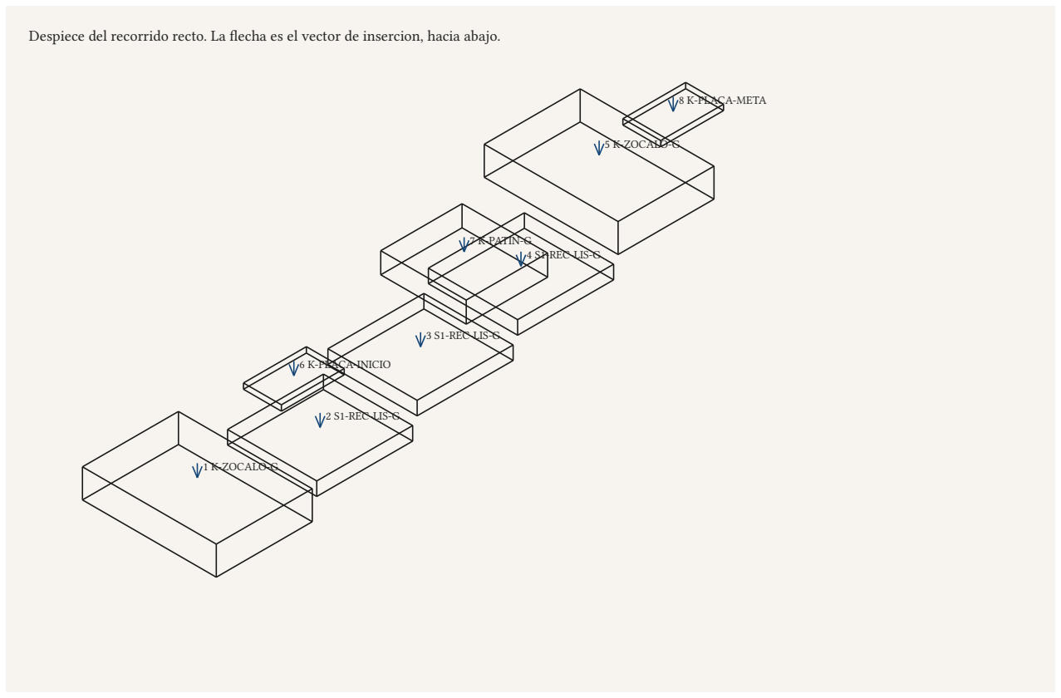
[picture p155: figure]
1 K-ZOCALO-G; 2 S1-REC-LIS-G; 3 S1-REC-LIS-G; 4 S1-REC-LIS-G; 5 K-ZOCALO-G; 6 K-PLACA-INICIO; 7 K-PATIN-G; 8 K-PLACA-META

Despiece del recorrido recto. La flecha es el vector de insercion, hacia abajo.

1. Coloca el zócalo de salida en la mesa. La espiga queda hacia el lado por donde seguirá el camino.
Coloca o zócalo de saída na mesa. A espiga queda cara ao lado por onde seguirá o camiño.
2. Baja la primera baldosa lisa sobre esa espiga. La ranura de 12 mm tiene que seguir sin escalón.
Baixa a primeira baldosa lisa sobre esa espiga. A rañura de 12 mm ten que seguir sen banzo.
3. Baja la segunda baldosa del mismo modo. Di, si quieres: «Step forward».
Baixa a segunda baldosa do mesmo xeito. Di, se queres: «Step forward».
4. Baja la tercera baldosa. El camino recto de la tarjeta ya está tendido.
Baixa a terceira baldosa. O camiño recto da tarxeta xa está tendido.
5. Baja el zócalo de llegada sobre la espiga de la última baldosa.
Baixa o zócalo de chegada sobre a espiga da última baldosa.
6. Encaja la placa INICIO. La esquina cortada solo entra de una forma. Si no entra, gírala: no la fuerces.
Encaixa a placa INICIO. A esquina cortada só entra dunha forma. Se non entra, víraa: non a forces.
7. Da la vuelta al patín para que el carril mire hacia abajo e introdúcelo en la ranura. Tiene que deslizar.
Dálle a volta ao patín para que o carril mire cara abaixo e introdúceo na rañura. Ten que esvarar.
8. Encaja la placa META en el zócalo de llegada, con la misma llave.
Encaixa a placa META no zócalo de chegada, coa mesma chave.

El niño desliza a Lúa por la ranura. El adulto puede decir «Step forward». Durante ese recorrido la tableta no se le acerca al niño.

O neno fai esvarar a Lúa pola rañura. O adulto pode dicir «Step forward». Durante ese percorrido a tableta non se lle achega ao neno.

### Lenguaje para el adulto

Categorías de BrickSmart en este set: posición y dirección, orientación, patrón, deícticos.

Castellano: delante, detrás, al lado, recto, giro, primero, luego, al final, este, aquel.

Galego: diante, detrás, ao lado, recto, xiro, primeiro, logo, ao final, este, aquel.

TPR, dicho por el adulto: Step forward, Turn left, Turn right, Stop, Jump, Follow the path.

Si el camino se corta, el mundo lo enseña. Se le dice al adulto que el camino está cortado y se pregunta si se puede girar la pieza. Sin reproche, sin usarlo como fallo del niño.

### Las otras dos tarjetas

Mismo gesto: bajar la pieza sobre la espiga. En la curva y en la rama de la T, el zócalo de llegada se gira 90 grados para que su hembra enfrente al macho.

- Una curva: K-ZOCALO-G, S1-CUR-G, K-ZOCALO-G, K-PLACA-INICIO, K-PLACA-META
- Una T: K-ZOCALO-G, S1-TEE-G, K-ZOCALO-G, K-ZOCALO-G, K-PLACA-INICIO, S1-DEST-CAMA, S1-DEST-PARQUE

### Ficha de comando

La ficha de comando baja al pozo de la baldosa, con el relieve hacia arriba. La esquina cortada impide ponerla al revés. No forma parte de la tarjeta recta; el kit sí la incluye.

A ficha de comando baixa ao pozo da baldosa, co relevo cara arriba. A esquina cortada impide poñela ao revés. Non forma parte da tarxeta recta; o kit si a inclúe.

### Revisión de diseño

Piezas aptas en esta máquina: 14. Rechazadas: 0. Cilindro de referencia: 31.75 mm × 57.1 mm. Pared mínima declarada: 3.2 mm. EN 71-1, criterio de diseño del README §7. No es ensayo de laboratorio.
