FrankBetances/lua-construye/sets/S1-camino/manual/tarjeta-recta.pdf

## Tarjeta de reto · camino recto

Copia este recorrido. El adulto lee. El niño mueve las piezas.

Planta. La flecha de montaje es vertical: la pieza baja sobre la espiga.

1. K-ZOCALO-G | 2. S1-REC-LIS-G | 3. S1-REC-LIS-G | 4. S1-REC-LIS-G | 5. K-ZOCALO-G K-PLACA-INICIO

K-PATIN-G

K-PLACA-META

1. Coloca el zócalo de salida en la mesa. La espiga queda hacia el lado por donde seguirá el camino.
2. Baja la primera baldosa lisa sobre esa espiga. La ranura de 12 mm tiene que seguir sin escalón.
3. Baja la segunda baldosa del mismo modo. Di, si quieres: «Step forward».
4. Baja la tercera baldosa. El camino recto de la tarjeta ya está tendido.
5. Baja el zócalo de llegada sobre la espiga de la última baldosa.
6. Encaja la placa INICIO. La esquina cortada solo entra de una forma. Si no entra, gírala: no la fuerces.
7. Da la vuelta al patín para que el carril mire hacia abajo e introdúcelo en la ranura. Tiene que deslizar.
8. Encaja la placa META en el zócalo de llegada, con la misma llave.

El niño desliza a Lúa por la ranura. El adulto puede decir «Step forward». Durante ese recorrido la tableta no se le acerca al niño.

El niño mueve los bloques. El adulto sostiene la tableta. La criatura no toca la pantalla.
