FrankBetances/lua-construye/sets/S4-maquina-soplo/manual/manual.pdf

## La Máquina de Soplo y Viento

Fase 8 del plan de impresión. Manual para el adulto que media.

El niño mueve las piezas. El adulto sostiene la tableta. La criatura no toca la pantalla. O neno move as pezas. O adulto sostén a tableta. A criatura non toca a pantalla.

### Escena

Juego de soplo y de causa-efecto. No es un ejercicio de habla ni un tratamiento del velo.

Xogo de sopro e de causa-efecto. Non é un exercicio de fala nin un tratamento do veo.

Lúa está de frente. Cada niño usa su embocadura, que no está en esta carpeta.

El reconocimiento es para el adulto que acompaña, no para el niño.

### Piezas

Código | Pieza | Cant.
S4-CAN-E | Cuerpo del canal | 2
S4-COD-E | Codo de 90 grados | 1
S4-ROT-JAULA-E | Jaula del rotor | 1
S4-ROT-ASPAS-E | Rotor de aspas | 1
S4-COM-LIG-E | Compuerta ligera | 1
S4-COM-PES-E | Compuerta pesada | 1
S4-MOL-JAULA-G | Jaula del molinete | 1
S4-MOL-ASPAS-G | Aspas anchas del molinete | 1
K-ZOCALO-G | Zócalo universal | 1
K-PLACA-FRONTAL | Placa Frontal | 1

### Orden

Cada pieza baja. El vector de inserción es (0, 0, −1).

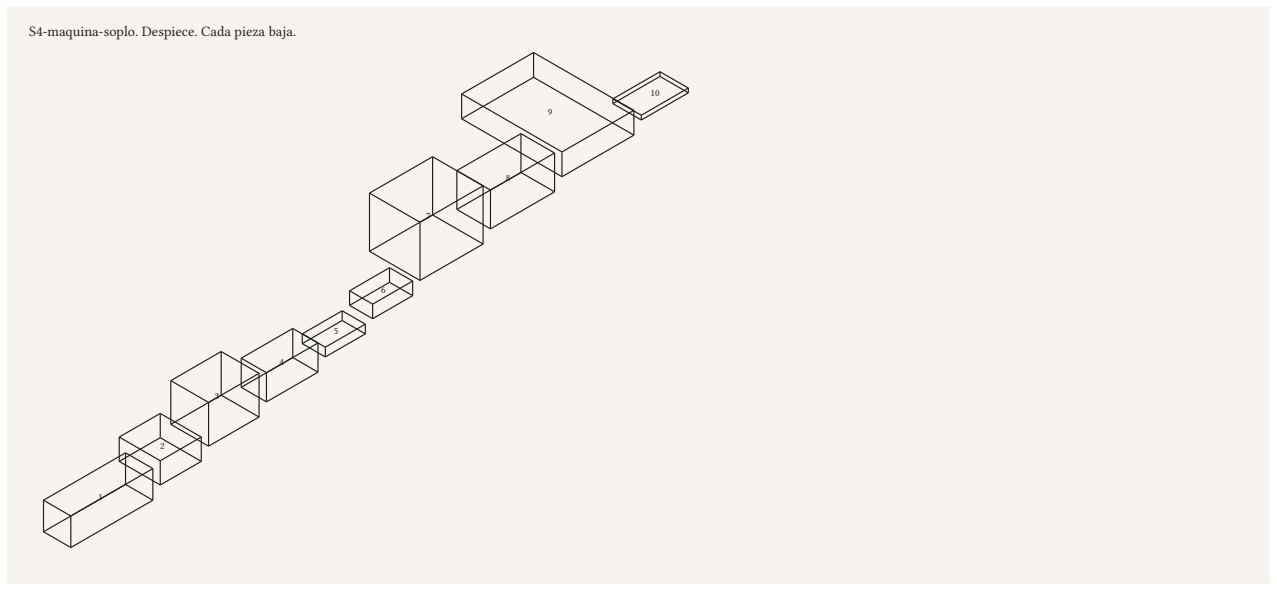
[picture p158: figure]
S4-maquina-soplo. Despiece. Cada pieza baja.

1. Baja la placa Frontal al zócalo. Lúa mira al niño. Las luces quedan apagadas.
Baixa a placa Frontal ao zócalo. Lúa mira ao neno. As luces quedan apagadas.
2. Acopla el canal y, si el reto dobla el aire, el codo.
Acopla a canle e, se o reto dobra o aire, o cóbado.
3. Mete el rotor en la jaula por el cojinete. Las aspas no salen de la jaula.
Mete o rotor na gaiola polo rodamento. As aspas non saen da gaiola.

4. Clava la compuerta ligera o la pesada en el pozo del canal.
Crava a comporta lixeira ou a pesada no pozo da canle.
5. Con menores de 3 años solo se usa el molinete, y sopla el adulto.
Con menores de 3 años só se usa o muiño, e sopra o adulto.

### Qué no va en esta carpeta

- S4-BOQ no se imprime en PLA por FDM. Cada niño necesita embocadura de otro proveedor, sin compartirla.
- S4-ROT-E y S4-MOL-G se parten en jaula y aspas. El eje es integral al rotor.
- El contrapeso de las compuertas es volumen de PLA, no un lastre suelto. Los gramos no se han pesado.

### Comprobación de diseño

10 de 10 mallas pasan el criterio de diseño (pared, cilindro, cama). No es un ensayo de laboratorio ni una impresión en Masque3D.

La planta del kit está en tarjetas/planta.svg.
