FrankBetances/lua-construye/docs/cad/manual/p1_probetas.png

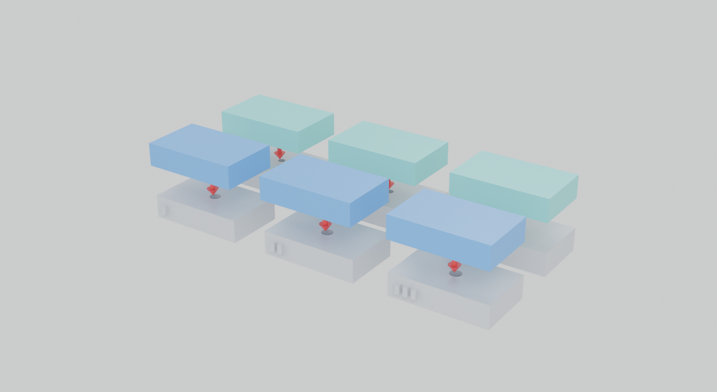
docs/cad/manual/p1_probetas.png
