FrankBetances/lua-construye/docs/cad/manual/s0_despiece.png

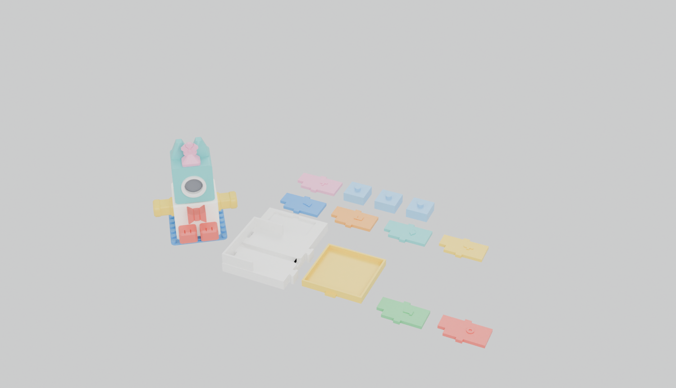
docs/cad/manual/s0_despiece.png
