FrankBetances/lua-construye/docs/cad/manual/s0_paso_1.png

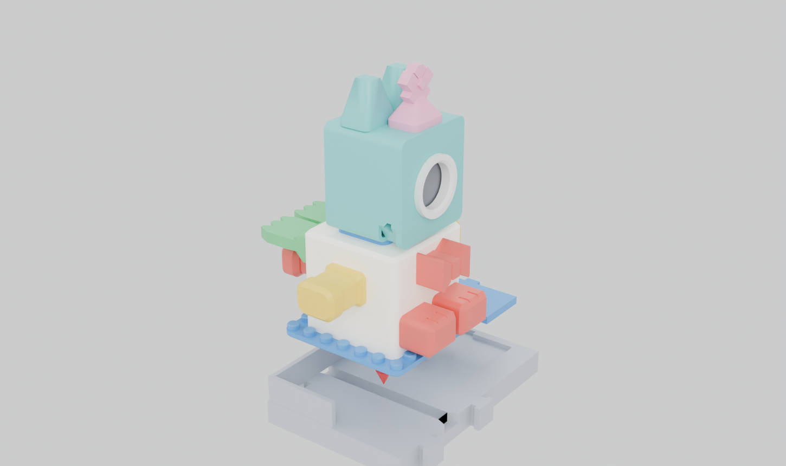
docs/cad/manual/s0_paso_1.png
