FrankBetances/lua-construye/docs/cad/manual/s0_paso_2.png

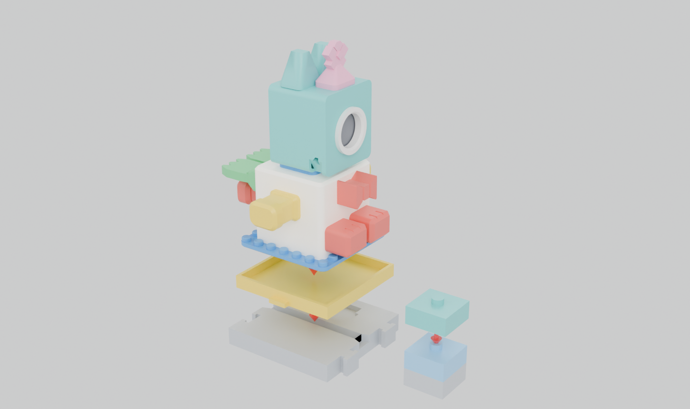
docs/cad/manual/s0_paso_2.png
