FrankBetances/lua-construye/docs/cad/manual/s6_despiece.png

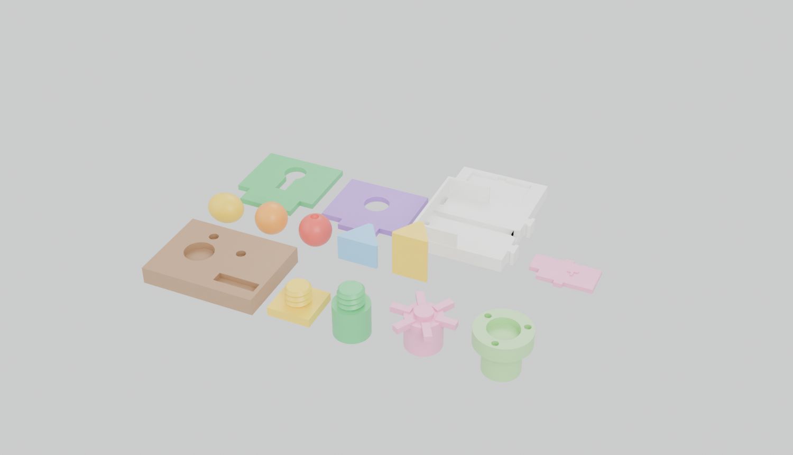
docs/cad/manual/s6_despiece.png
