FrankBetances/lua-construye/docs/cad/manual/s6_paso_1.png

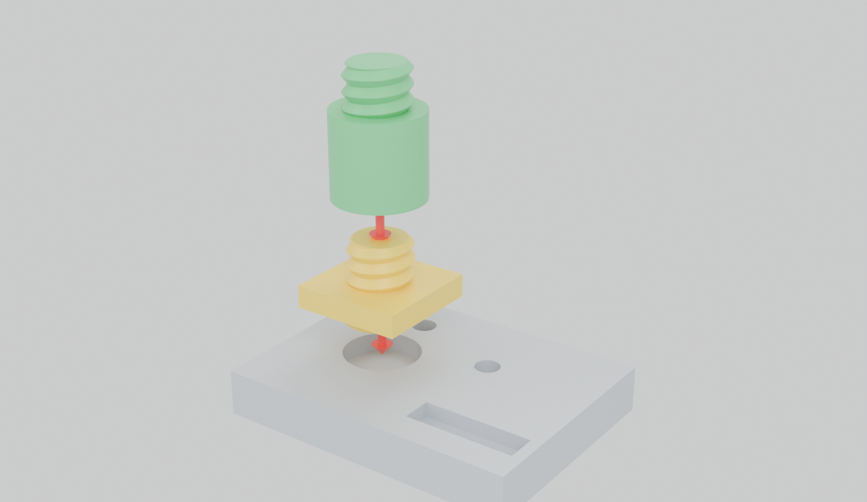
docs/cad/manual/s6_paso_1.png
