FrankBetances/lua-construye/docs/cad/manual/s6_paso_2.png

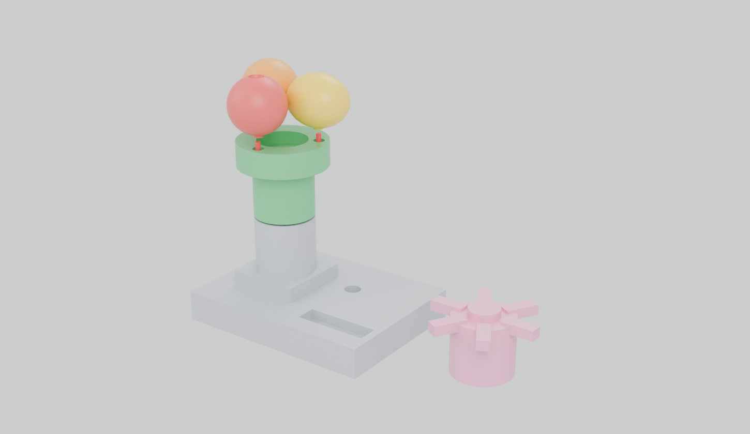
docs/cad/manual/s6_paso_2.png
