FrankBetances/lua-construye/docs/cad/manual/s6_paso_3.png

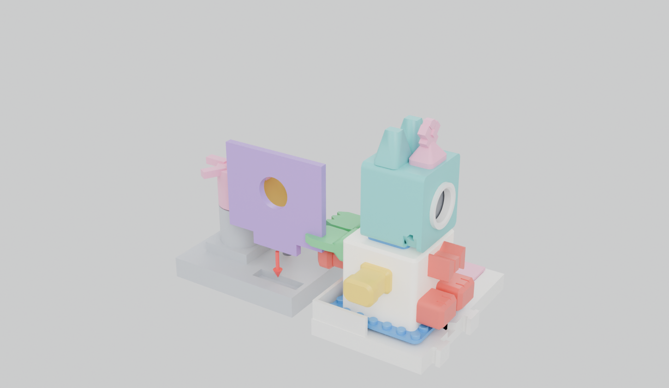
docs/cad/manual/s6_paso_3.png
