FrankBetances/lua-construye/docs/cad/manual/s8_policia.png

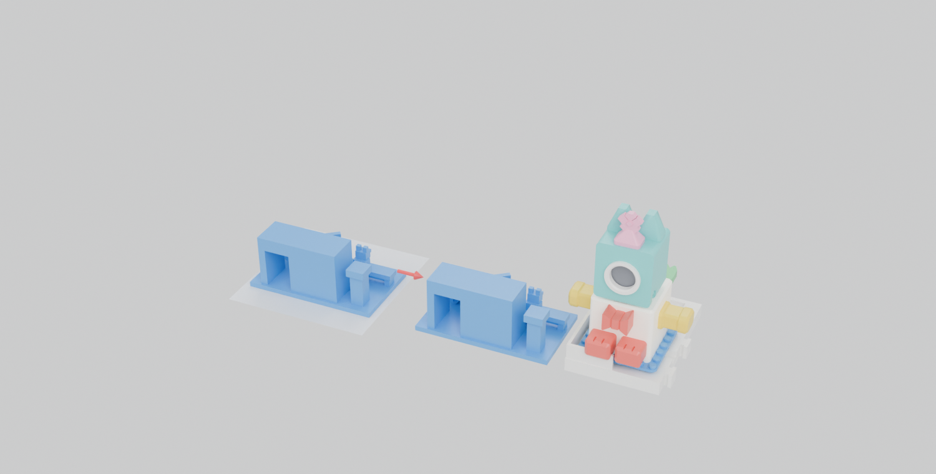
docs/cad/manual/s8_policia.png
