FrankBetances/lua-construye/docs/cad/manual/s11_trenes.png

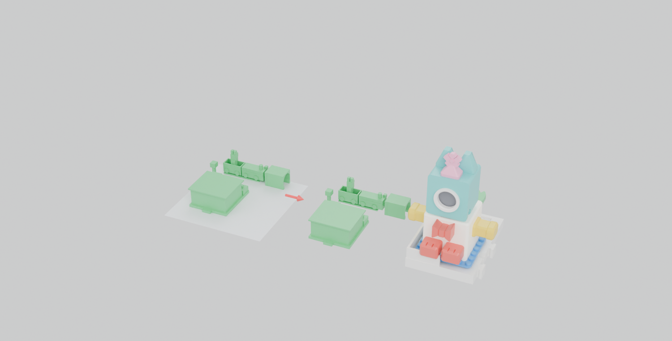
docs/cad/manual/s11_trenes.png
