FrankBetances/lua-construye/docs/cad/manual/taller_sostenes.png

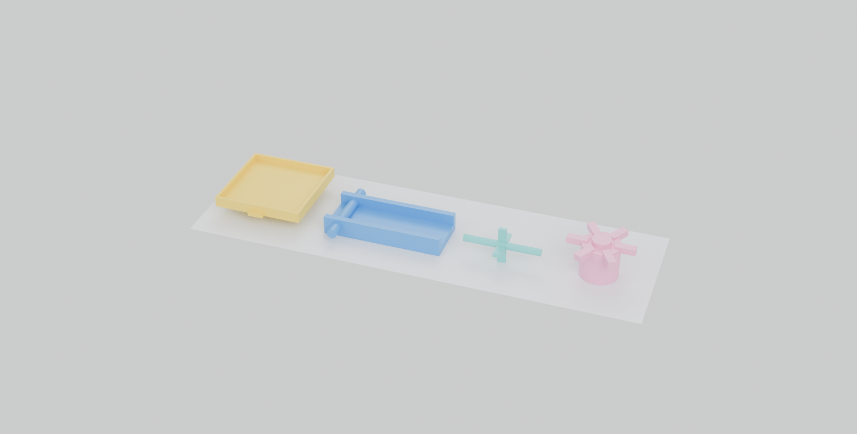
docs/cad/manual/taller_sostenes.png
