FrankBetances/lua-construye/(commit log)

2026-10-28 docs: actualizar README con especificación V5 de Construye con Lúa
2026-10-28 docs: añadir especificación de los mundos (SETS.md)
2026-10-28 feat: ejemplo ejecutable del Set 1, El Camino de Lúa
    Siete agentes recorren el set: BOM y DAG, STL herméticos con manifold3d, GLB de menos de 100 KB, auditoría de diseño, secuencia de montaje, SVG y manual Typst.
    [K-PATIN-G.stl, K-PLACA-INICIO.stl, K-PLACA-META.stl, K-ZOCALO-G.stl, S1-CMD-AVA-G.stl, S1-CMD-GIR-G.stl, S1-CMD-PAR-G.stl, S1-CMD-SAL-G.stl]
2026-10-28 feat: carpetas de impresión de la probeta, el kit y los sets 2 a 6
    Cada carpeta lleva STL herméticos, BOM, orden, despiece y manual. El Set 1 permanece en sets/S1-camino.
    [K-COLA-G.stl, K-LOMO-G.stl, K-PATA-DEL-G.stl, K-PATA-TRA-G.stl, K-PATIN-G.stl, K-PLACA-ESCUCHA.stl, K-PLACA-FRONTAL.stl, K-PLACA-INICIO.stl]
2026-10-29 feat: carpeta independiente de escenas y oficios
    Guarda las ocho escenas y los cuatro oficios (PNG y STL de conjunto) fuera de las carpetas de impresión.
    [S0-kit-lua.stl, S1-camino.stl, S2-estacion-sonido.stl, S3-laboratorio-rampas.stl, S4-maquina-soplo.stl, S5-puente-equilibrio.stl, S6-jardin.stl, S7-granja.stl]
2026-10-29 feat: sets profesionales en sets, comisaría bomberos hospital y trenes
    Copia la escena y el STL de conjunto junto al resto de sets. v1 no se mueve.
    [conjunto.stl]
2026-10-29 Sets v1 compatibles con Lúa V5 y carpeta para masque3d
    Frank, 29/10: analizar los sets v1, hacerlos compatibles con Lúa V5 de
    lua-firmware y generar una carpeta con todos los STL para masque3d.
    Lúa V5:
    - lua-v5/: copia de la interfaz y del patín de lua-firmware; agents/lua_v5
    la trae y la compara (make check).
    - Zócalo nuevo: cuna con la huella de Lúa V5, abierta por delante; al revés
    las patas chocan. Placa en una franja aparte.
    - K-PATIN-G es el patín de Lúa V5 (dos clics, dos pivotes). El de la v1 no
    se enganchaba y no pasaba por la curva.
    - agents/check_lua_camino: Lúa V5 en recta, curva, T y zócalo. Rojo con
    --romper sin_patin y al_reves.
    - El Set 0 ya no lleva el cu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
    [K-PATIN-G.stl, K-PLACA-ESCUCHA.stl, K-PLACA-FRONTAL.stl, K-PLACA-INICIO.stl, K-PLACA-JARDIN.stl, K-PLACA-META.stl, K-PLACA-NIVEL.stl, K-PLACA-RECEPTOR.stl]
2026-10-29 Sets 8 a 11 escalados a la cama en la carpeta para masque3d
    Frank: todos los sets. Policía, bomberos y hospital al 60 %, trenes al 33 %,
    con sostén. Medida: policía en verde; los otros tres con un fallo cada uno,
    dicho en el LEEME. NO PROBADO.
    Claude-Session: https://claude.ai/code/session_01KaBg32Uc28cn3wjyPkgaJu
    [S10-hospital-escala-60.stl, S11-trenes-escala-33.stl, S8-policia-escala-60.stl, S9-bomberos-escala-60.stl]
2026-10-29 WIP: patín en bandeja y cuna para el cubo de Lúa V5 (sin medir, sin regenerar el pack)
    El pack de main aún lleva K-PATIN-G y K-ZOCALO-G del cuerpo antiguo: no enviar.
    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
    [patin-imprimir.stl, patin-montaje.stl]
2026-10-29 WIP: patín y cuna para el cubo de Lúa V5; pack sin regenerar
    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
    [K-PATIN-G.stl, K-PLACA-ESCUCHA.stl, K-PLACA-FRONTAL.stl, K-PLACA-INICIO.stl, K-PLACA-JARDIN.stl, K-PLACA-META.stl, K-PLACA-NIVEL.stl, K-PLACA-RECEPTOR.stl]
2026-10-29 CLAUDE.md: regla número uno de Frank (30/10)
    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
2026-10-29 Pack masque3d regenerado: patín y cuna para el cubo de Lúa V5, escenas 8 a 11
    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
    [K-PATIN-G.stl, K-PLACA-ESCUCHA.stl, K-PLACA-FRONTAL.stl, K-PLACA-INICIO.stl, K-PLACA-JARDIN.stl, K-PLACA-META.stl, K-PLACA-NIVEL.stl, K-PLACA-RECEPTOR.stl]
2026-10-29 LEEME del pack: el patín es una bandeja para el fondo del cubo
    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
2026-10-29 docs: generar manual de ensamblaje tipo IKEA para los 11 sets en PDF
2026-10-30 docs: rehacer manual IKEA de los 11 sets con 34 renders 3D en Blender Cycles y cero solapes
2026-10-30 fix(masque3d): eliminar soportes modelados de los 87 STL de los sets para laminar en taller
    [K-PATIN-G.stl, K-PLACA-ESCUCHA.stl, K-PLACA-FRONTAL.stl, K-PLACA-INICIO.stl, K-PLACA-JARDIN.stl, K-PLACA-META.stl, K-PLACA-NIVEL.stl, K-PLACA-RECEPTOR.stl]
